MacAnalog/agentic-design-pam4-driver-ihp130/README.md

# Agentic design of a 96 Gb/s PAM-4 driver — IHP SG13G2 (130 nm SiGe BiCMOS)

AI-agent-driven, fully scripted design of an inductorless PAM-4 optical
modulator driver — a block-level replication of *Inac et al., "Inductorless
96 Gb/s PAM-4 Optical Modulators Driver in SiGe:C BiCMOS," EuMIC 2022* on
the open IHP SG13G2 PDK — taken from netlist to DRC/LVS-clean parameterized
layout, kpex extraction, and a layout + electrical co-optimization that
closes **all eight post-layout specs** — first with a block-local optimizer
(v2), then by running the paper's **layout/schematic co-design algorithm
through the SpiceXplorer platform** (`spicexplorer-optimize`,
`sim_engine: layout`; three rounds — **v4** is the layout of record). The audit
trail is four notebooks plus a self-contained **reviewer report** ([`report/`](report/README.md):
schematic vs v1 / v2 / v3 / v4 layouts through the same benches, DRC/LVS/PEX
evidence, GDS + netlists, KLayout renders, eyes, tables — `make report`);
every result below reproduces from this repo — and every number in the
final table can be re-run by hand from static ngspice decks:
[`verification/`](verification/README.md) (`make verify-report`).

## The layout journey

Original v1 layout (edge-fed input, 1.8 µm output-bus gap, nx=2 / R_C=70 Ω
electrical point) → the co-designed layout of record (v4):

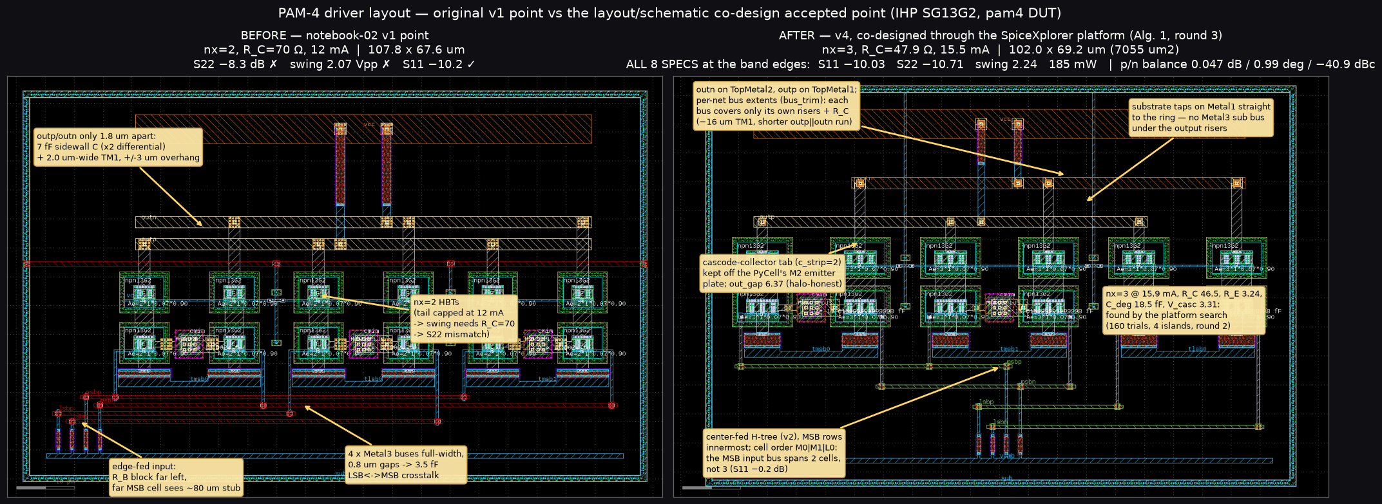
[picture p1: layout/before_after.png]
before/after layout: original v1 vs the co-designed layout of record


The first optimization pass scored only S11/BW/gain/power — and its winner
(nx=2, R_C=70 Ω) sailed through those while silently **failing S22
(−8.3 dB) and output swing (2.07 Vpp)**, caught by the full signoff
(notebook 03). An expert RF layout review + a directed probe ladder
produced the v2 fix (`layout/before_after_v2.png` shows v1 → v2), and the
punchline: **once the layout was repaired, the electrical optimum returned to
the paper's nominal topology** (nx=3, R_C=50 Ω) — the odd v1 sizing had been
compensating layout parasitics.

| step | what was learned / changed | effect |
|---|---|---|
| v1 signoff | S22 and swing were never in the objective — R_C=70 bought gain with output mismatch | S22 −8.3 ✗, swing 2.07 ✗ |
| C-budget from extraction | output C, not R_C mismatch, limits S22: ~14 fF/side of bus wiring (kpex charges TM1 37 aF/µm of *edge* to substrate — length is everything) + ~14 fF/side cascode junctions; outp↔outn sidewall counts **double** differentially | fix must be geometric |
| output-network fixes | bus gap 1.8→8 µm, min-width TM1, slim risers/via stacks, ±1.5 µm overhang, compacted row | S22 −8.4 → **−10.14** at R_C=50 |
| input-network fixes | center-fed H-tree R_B (kills the far-MSB-cell ~80 µm stub), Metal4 buses with MSB rows innermost, 3 µm pair gap, Metal2 base drops | msb S11 at nx=3: −8.8 → −9.9 |
| electrical re-tune | tail 15 mA, R_B 48, V_casc 3.35, and **R_E 2.5→3.2 Ω** — series feedback shrinks the effective input C (the HBT model scales with Nx only) | S11 **−10.03** ✓ with gain 8.25 ✓ |
| verify | kpex RC mode ≡ CC mode to 0.01 dB; DRC + LVS clean on all 3 DUTs | point frozen as v2 (`gen_layout.V2_LAYOUT`) |

### v3 — co-design through the platform (2026-08-18)

Running the same loop *through* `spicexplorer-optimize` (Algorithm 1 of the
TCAS paper: agent owns the generator + bounds, platform owns the search,
DRC/LVS as gates; `layout/codesign/`) first fixed the **instrument** — the
v2 "−10.03 / −10.14" were the worst points of a `dec 20` grid that never
samples 32 / 50 GHz; at the band edges v2 reads **−9.94 / −9.24 dB and
fails both reflection specs** — and the extractor's 8 µm sidewall halo
(`out_gap` sat on it; now `pex.halo_um: 20`). Round 1 (120 trials) skipped
47 % of its budget on generator DRC bugs → three guards; round 2 turned the
layout review into five **structural INT knobs** (`bus_trim`, `sub_bus`,
`cell_order`, `c_strip`, `out_split`) and found the accepted point:

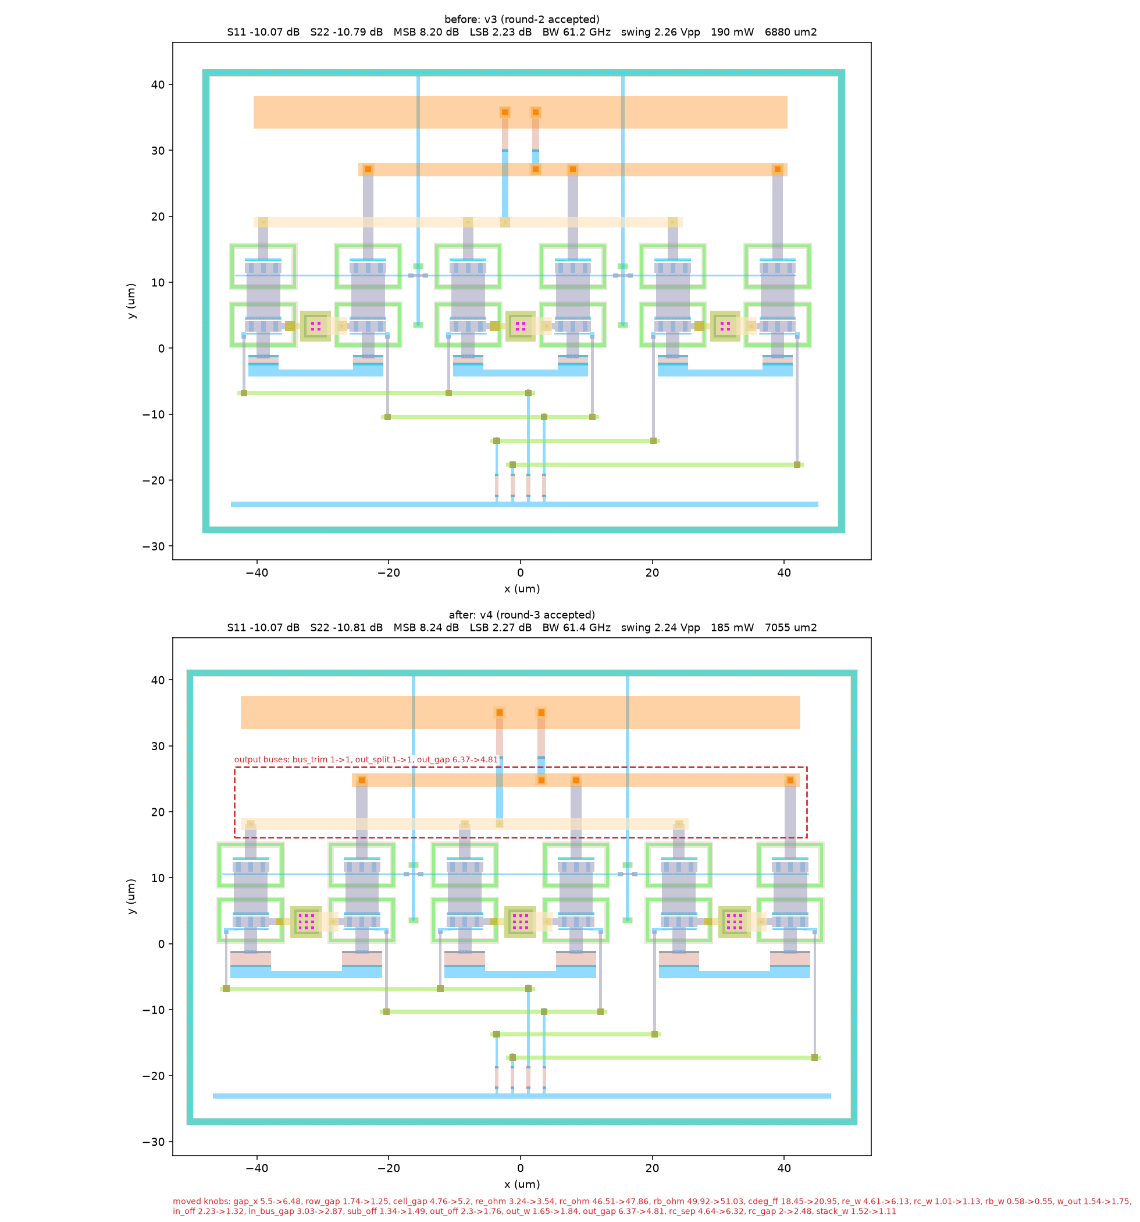
[picture p2: layout/codesign/before_after.png]
before/after co-design


| | v2 (record) | **v3 accepted** |
|---|---|---|
| S11 @32 GHz / S22 @50 GHz | −9.94 / −9.24 dB ✗✗ | **−10.05 / −10.72 dB** ✅✅ (halo 20: −10.07 / −10.78) |
| gain LSB / MSB, BW, swing, power | 2.27 / 8.25 dB, 58.8 GHz, 2.21 Vpp, 179 mW | 2.23 / 8.21 dB, 61.1 GHz, 2.26 Vpp, 190 mW |
| core area | 7552 µm² | **6880 µm²** (−9 %; −39 % vs the paper's 11 300) |

### v4 — co-design round 3: p/n balance as an objective (2026-08-18)

The r2 review's open item was **matching**: the accepted v3 floorplan is
asymmetric by construction (one output bus on TopMetal2, per-net bus trimming)
and its p/n balance had degraded (0.053 dB / 1.18° / −39.4 dBc against v2's
0.03 / 0.5° / −46.5). Round 3 measured the balance of *both* DAC paths in the
hook, made it a **reward** in `J` (with power), and added the knobs the
extraction pointed at — the symmetric/mirrored `out_split` variants, a
p/n-swapped input row order, and `rc_gap` (the outn bus ↔ TopMetal2 vcc rail,
2.34 fF against outp's 0.26). 520 trials over 14 islands:

| | v3 | **v4 accepted** |
|---|---|---|
| S11 @32 GHz / S22 @50 GHz (halo 20 CC) | −10.070 / −10.790 dB | **−10.073 / −10.812 dB** |
| p/n \|gain\| / phase / diff→CM ≤ 48 GHz | 0.043 dB / 0.88° / −41.9 dBc | **0.035 dB / 0.64° / −44.5 dBc** |
| gain LSB / MSB, BW, swing, power | 2.232 / 8.205 dB, 61.2 GHz, 2.26 Vpp, 190.2 mW | 2.269 / 8.244 dB, 61.4 GHz, 2.24 Vpp, **185.0 mW** |
| core area | 6880 µm² | 7055 µm² (+2.5 %; −38 % vs the paper's 11 300) |

The *symmetric* metal options and the input-row swap were measured and are
**nulls** — the balance came from the per-net C budget (output-net asymmetry
2.01 → 1.46 fF) and the electrical point; and the round's ceiling is that
every larger balance gain costs 0.1–0.5 dB of S22 (only 6 of 520 trials hold
both reflections at the v3 level).

Full story, rounds table, ceiling analysis and the annotated parameterized
layout: [layout/codesign/README.md](layout/codesign/README.md); notebook 04.

#### Where the co-optimization actually happens (the script to read)

The agent-generated layout (`layout/gen_layout.py`, a gdsfactory generator
whose `LayoutParams` are the knobs) and the schematic sizing were co-optimized
**by `spicexplorer-optimize`**, not by any loop in this repo. Everything the
platform needs is in **[`layout/codesign/`](layout/codesign/)** — three files:

| file | role in Alg. 1 |
|---|---|
| [`flow.yaml`](layout/codesign/flow.yaml) | `layout-flow/1`: *what one trial is* — `generator: ../gen_layout.py`, `cell`, KLayout DRC + LVS (per-trial reference from the generator), kpex 2.5D (`mode: CC`, MIM stripped, `halo_um: 20`), and the `measure:` hook; `gates: {drc, lvs, pex}` = the skip rule |
| [`project_setup.yaml`](layout/codesign/project_setup.yaml) | `sim_engine: layout`: *the search* — `dut_params` = θ_E ∪ θ_L ∪ θ_S with `init` = the layout of record (`seed_from_init`), `target_specs` = the eight signoff specs as feasibility bounds + S11/S22/p-n-balance/power/area margins as the reward (`feasibility_reward` J), `ic_ma_per_finger` validity, DRC/LVS/PEX gates as `exact 1` specs |
| [`measure_post.py`](layout/codesign/measure_post.py) | the hook `measure(req) -> scalars`: kpex netlist → `pex_sim.convert_pex_netlist` (MIM re-inserted) → `wrap_layout_dut` → the block's own `driver_lib` benches (`run_ac`, `run_ac_s22`, `run_dc`, bias) with the trial's sizing + `deck_params` (tail, V_casc) → `s11, s22, msb_gain, lsb_gain, weight, bw, swing, power, ic_ma_per_finger` |

```yaml
# project_setup.yaml (excerpt) — one line per knob; the platform owns Opt.ask/tell
project:
  sim_engine: layout
  netlist: flow.yaml                     # the DUT "netlist" is the layout-flow spec
  dut_params:
    - { name: nx,       min_val: 2,   max_val: 4,    init: 3,    is_integer: true }   # θ_E (draws geometry)
    - { name: tail_ma,  min_val: 10.0, max_val: 17.5, init: 15.0 }                    # θ_E (bench-only -> deck_params)
    - { name: rc_ohm,   min_val: 40.0, max_val: 70.0, init: 50.0 }
    - { name: out_gap,  min_val: 3.0,  max_val: 20.0, init: 8.0 }                     # θ_L (um)
    - { name: bus_trim, min_val: 0,   max_val: 1,    init: 0,    is_integer: true }   # θ_S (round-2 structural option)
    # ... 33 knobs in all
  target_specs:
    - { name: s11, goal: minimize, target: -10.0, range: 5.0, weight: 10, reward_type: relative-absolute }
    - { name: s22, goal: minimize, target: -10.0, range: 5.0, weight: 10, reward_type: relative-absolute }
    - { name: msb_gain, goal: exceed, target: 8.2, range: 1.0, weight: 5, reward_type: none }
    # ... lsb_gain, weight, bw, swing, power, ic_ma_per_finger, drc_pass/lvs_match/pex_ok (exact 1)
  optimizer_config: { type: nevergrad, name: TwoPointsDE, seed_from_init: true }
```

One island of a round is one platform command (what `run_round.sh` /
`make codesign` wrap):

```sh
uv run --project ../../../../spicexplorer-platform spicexplorer-optimize \
    layout/codesign/project_setup.yaml --budget 40 --seed 0 --algo OnePlusOne \
    --outdir layout/codesign/runs/r2_s0
```

Every trial leaves `runs/<round>_s<seed>/layout/layout/run_<n>_layout/{pam4drv_pam4_lay.gds, drc/, lvs/, pex/, measure.log, summary.json}`;
`harvest.py` folds the islands into `results/<round>/{trials.jsonl,summary.json,best.*}` — the record R the agent reads
(and notebook 04 plots). The agent's part of the loop is only the diff of `gen_layout.py` and the bounds between rounds
(`rounds/r1_project_setup.yaml` → `project_setup.yaml`).

Open pre-tapeout items from the review (vcasc bypass/stability, EM current
density, ground cage, matching dummies) are tracked in
[layout/LAYOUT_REVIEW.md](layout/LAYOUT_REVIEW.md).

## Results

| metric (post-layout `pam4`, kpex 2.5D) | paper (meas.) | EIC ref (schem) | v2 (2026-08-09) | v3 (co-design r2) | **v4 (layout of record)** | spec |
|---|---|---|---|---|---|---|
| LSB / MSB LF gain | 3.2 / 9.2 dB | 3.10 / 9.07 | 2.27 / 8.25 dB | 2.23 / 8.20 dB | **2.27 / 8.24 dB** | ≥ 2.2 / ≥ 8.2 ✅ |
| DAC weight | 6.0 dB | 5.97 | 5.98 dB | 5.97 dB | **5.97 dB** | ≥ 5.0 ✅ |
| Bandwidth (worst path) | 51–67 GHz | 66.6 | 58.8 GHz | 61.1 GHz | **61.1 GHz** | ≥ 50 ✅ |
| S11 at 32 GHz | < −10 | −10.87 | −9.94 dB ✗ | −10.05 dB | **−10.03 dB** | ≤ −10 ✅ |
| S22 at 50 GHz | < −10 | −14.75 | −9.24 dB ✗ | −10.72 dB | **−10.71 dB** | ≤ −10 ✅ |
| p/n balance ≤ 48 GHz (gain / phase / diff→CM) | — | ideal | 0.03 dB / 0.5° / −46.5 dBc | 0.05 dB / 1.2° / −39.5 dBc | **0.05 dB / 1.0° / −40.9 dBc** | audit |
| Max diff swing | 2.1 Vpp | 2.37 | 2.21 Vpp | 2.26 Vpp | **2.24 Vpp** | ≥ 2.1 ✅ |
| Power | 192 mW | 191 | 179 mW @ 4 V | 190 mW @ 4 V | **185 mW @ 4 V** | ≤ 192 ✅ |
| 48 GBd PAM-4 eye (200 mV$_{pp}$ in) | Fig. 5 | RLM 0.995, 0.25 V eyes | RLM 0.995, 0.23 V eyes | RLM 0.995, 0.23 V eyes | **RLM 0.994, 0.23 V eyes** | open ✅ |
| Core area | 0.011 mm² | — | 0.0076 mm² | 0.0069 mm² | **0.0071 mm²** (102.0 × 69.2 µm) | — |

S11/S22 are the worst in-band values *including the interpolated 32 / 50 GHz
band edge* (kpex CC, tech halo 8 µm — the block's default instrument; the
v2 column is the record re-measured that way, see the v3 section above). The
co-design search runs at halo 20, where v4 reads −10.073 / −10.812 dB and
0.035 dB / 0.64° / −44.5 dBc — better than v3 on every one of them.
Eye metrics are read at the eye centre (`report/build_report.py`; the
notebooks sample at a fixed phase and read RLM ≈ 0.97). All five tiers —
schematic, first-pass layout, v2, v3, v4 — side by side with the same instrument,
plus the p/n balance audit and per-tier DRC/LVS/PEX evidence, are in
[`report/`](report/README.md) (`report/data/tables.md`).
Both columns through the same `driver_lib` benches (notebook 04 §5):

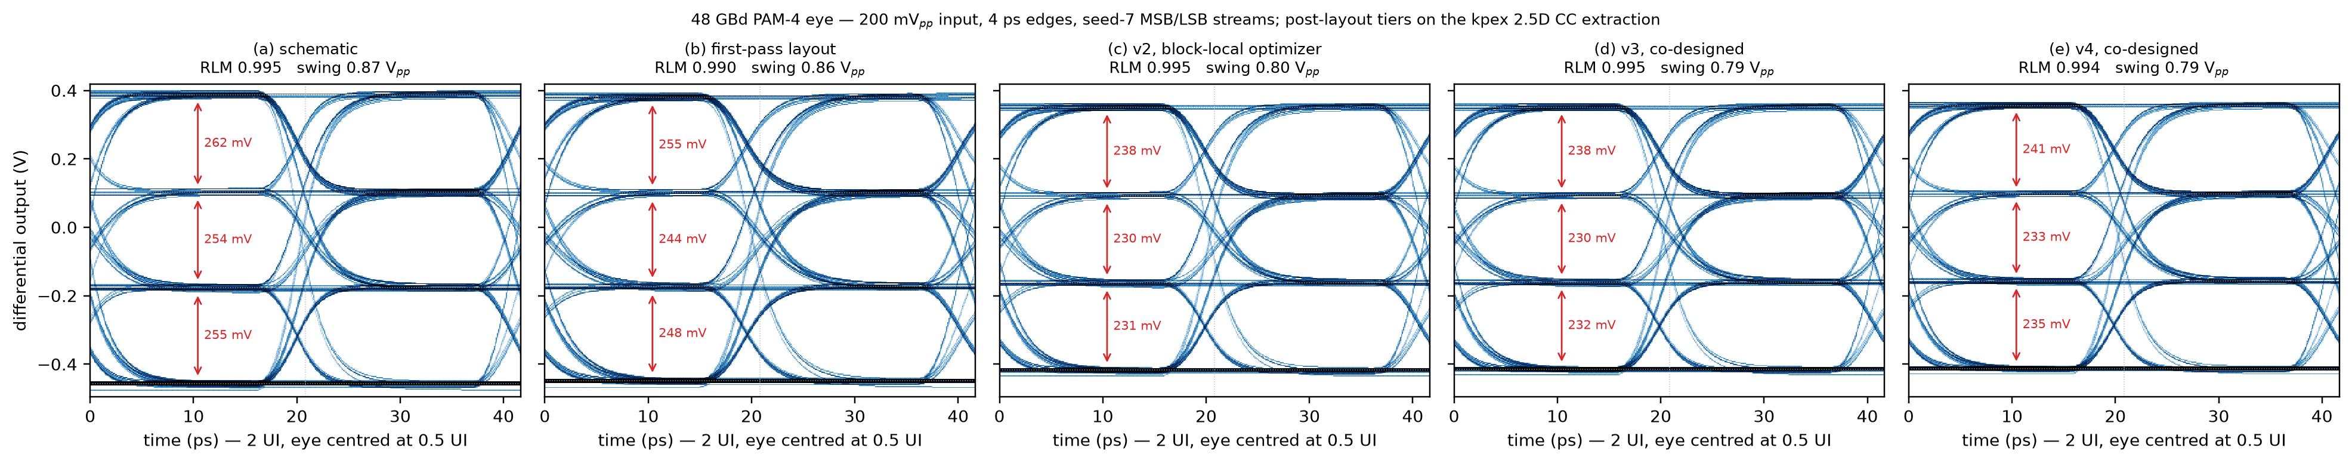
[picture p3: report/figs/fig_eye.png]
48 GBd eyes, all five tiers


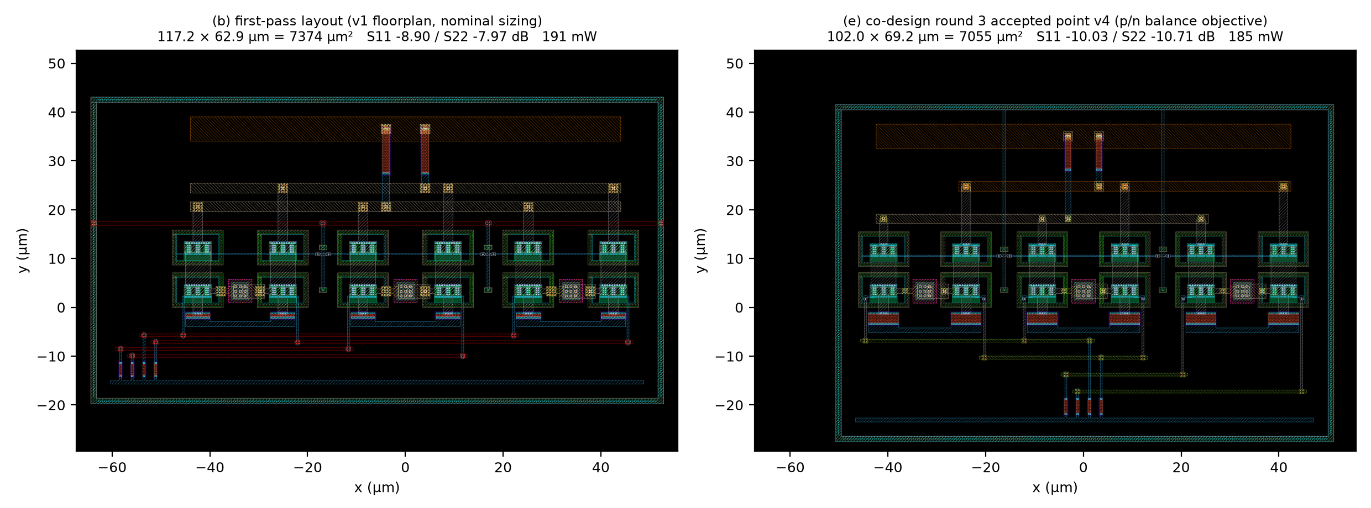
[picture p4: report/figs/fig_layout_b_vs_d.png]
first-pass vs co-designed layout, KLayout render


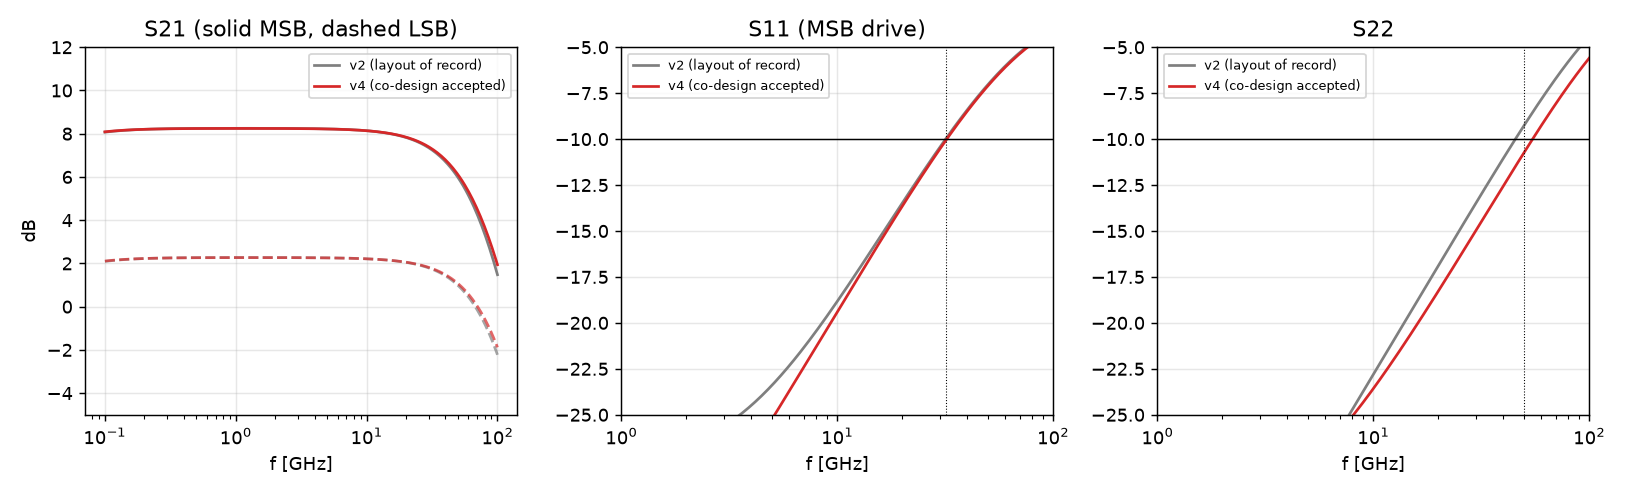
[picture p5: notebooks/report_figs/sparams_v2_v4_post_layout.png]
v2 vs v4 S-parameters


**S-parameters, all five tiers** (S21 both paths, S11, S22 — schematic /
first-pass / v2 / v3 / v4, `report/`):

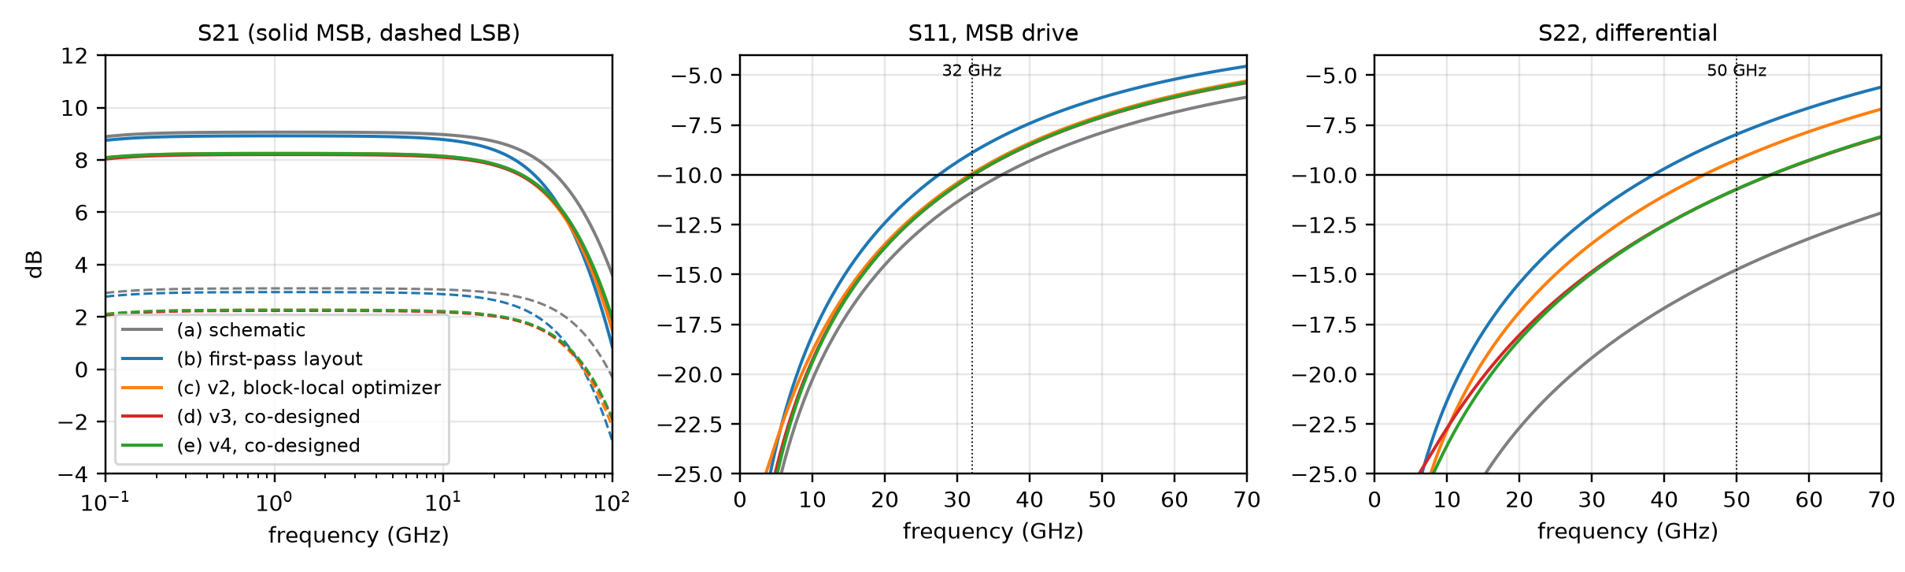
[picture p6: report/figs/fig_sparams.png]
s-parameters


**DC transfer** (swing signoff, all tiers) and **p/n balance audit**:

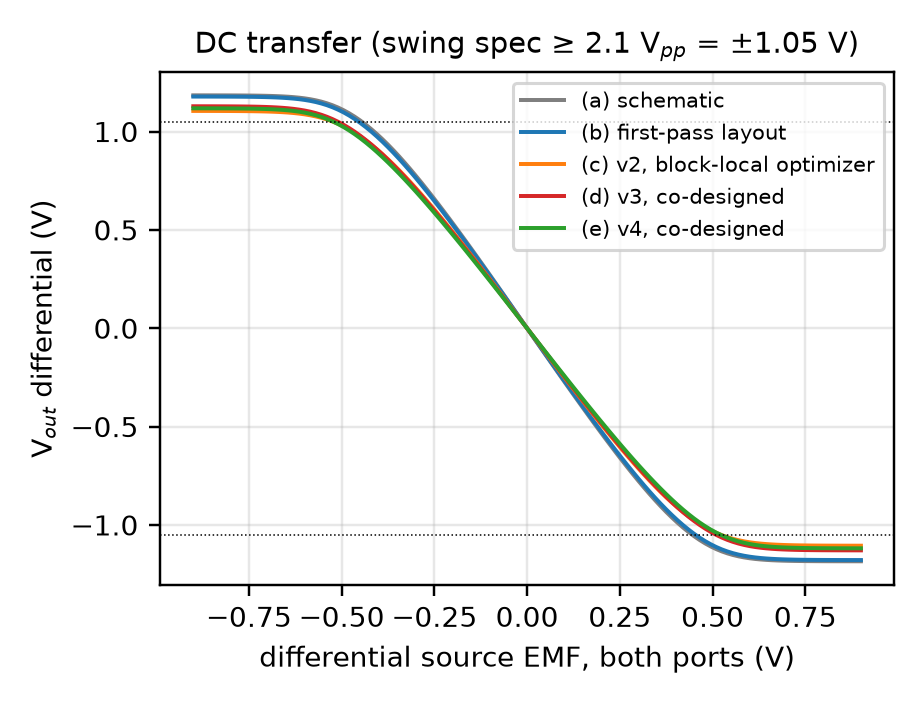
[picture p7: report/figs/fig_dc.png]
dc transfer

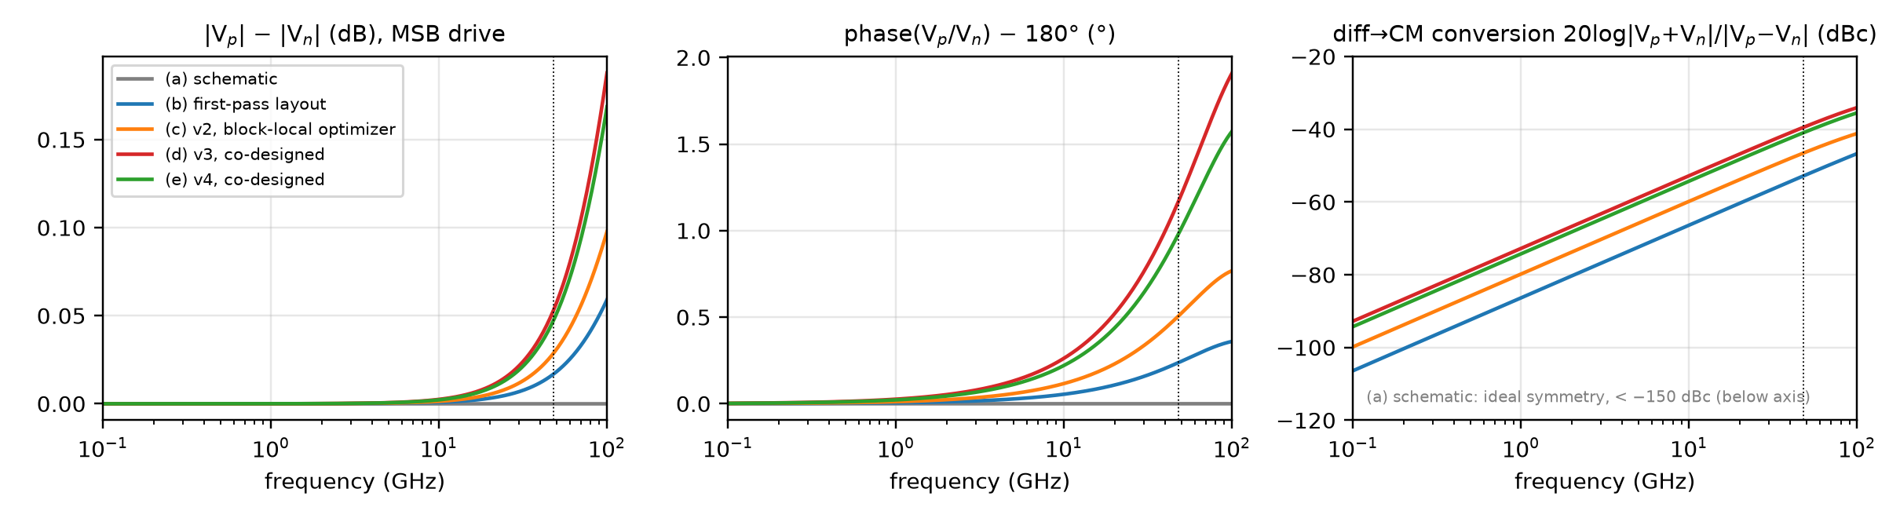
[picture p8: report/figs/fig_balance.png]
balance


**Final pam4 layout — v4, the layout of record** (3 differential cascode
cells summing into shared collector loads; DRC + LVS clean; KLayout render,
every optimizer knob annotated):

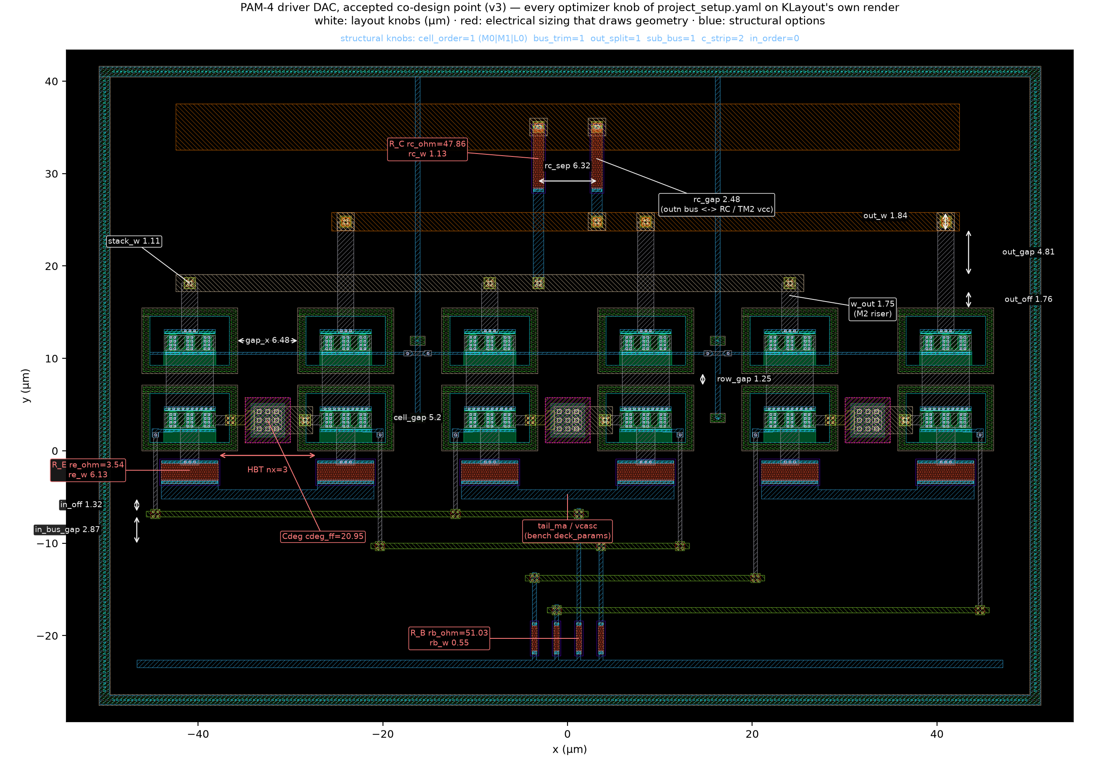
[picture p9: report/figs/fig_layout_annotated.png]
final layout v4


The notebook-03 signoff figures (`notebooks/report_figs/{pam4_layout_final,
eye_48gbd_pam4,sparams_s21_s11_s22,dc_transfer_dac_levels}.png`) are the
**v2** layout of record (they run on `layout/out/pex/dut_pam4_best_post.spice`);
`report/` supersedes them for v3 / v4.

The report plots regenerate with `make report`, the notebook plots from
`notebooks/03_signoff.py`; the executed
notebooks (`.ipynb` built locally from the paired `.py`, `make notebooks`)
contain every table and figure inline:

| notebook | contents |
|---|---|
| [01_schematic_sizing](notebooks/01_schematic_sizing.py) | DUT schematics, testbenches, nominal sizing, bias/S-param/eye vs the verified reference |
| [02_layout_in_the_loop](notebooks/02_layout_in_the_loop.py) | gdsfactory generation, DRC/LVS, kpex, co-optimization with the **full 8-spec objective** |
| [03_signoff](notebooks/03_signoff.py) | DC/tran/AC/eye on schematic **and** post-layout through the *same* benches; master spec table; `emitter_width=0.07` validity proof |
| [04_codesign_platform](notebooks/04_codesign_platform.py) | the platform co-design record (`layout/codesign/results/`): per-round trial scatter / skip rates, round-by-round scorecard vs the honest baseline, moved knobs, annotated parameterized layout + before/after + rounds strip |

## Repo map

```
dut/          three DUT subcircuits (lsb / msb / pam4 2-bit DAC)
netlists/     static, directly runnable ngspice decks (+ .spiceinit)
testbenches/  driver_lib.py — netlist-agnostic benches (schematic AND
              post-layout via dut_ref=), run_verify.py, run_eye.py
layout/       gen_layout.py (parameterized generator, FINAL_LAYOUT = v4,
              V3_LAYOUT, V2_LAYOUT), signoff.py (DRC+LVS, vendored PDK runner),
              pex_sim.py (kpex), optimize_layout.py (block-local v1/v2 loop),
              LAYOUT_REVIEW.md, before_after.png (v1 -> v4; _v2/_v3 = v1 -> v2/v3),
              codesign/ (Alg. 1 through spicexplorer-optimize: flow.yaml,
              project_setup.yaml, measure hook, rounds/, results/, figures),
              out/ (v3 netlists, PEX, renders; GDS regenerates)
report/       reviewer report — build_report.py, README.md, figs/, data/
              (tables + raw sweeps), layout/<tier>/ (GDS + LVS/kpex/post
              netlists + DRC/LVS logs), schematic/  (make report)
verification/ static ngspice decks per tier + extract.py + verify.py:
              re-run and check every final number (make verify-report)
notebooks/    jupytext .py sources (+ locally built .ipynb) + report_figs/
results/      committed characterization plots + metrics YAML
schematics/   xschem schematics (paper Fig. 1 / 2a / 2b)
docs/         REFERENCE.md — detailed methods, measurement conventions,
              JPP-361 ngspice finding, provenance
```

## EDA tool setup

One-time, per machine. Install the tools wherever you like, then record the
paths in an untracked `local.mk` at the repo root — the Makefile injects
them into every flow.

1. **PDK** — clone [IHP-Open-PDK](https://github.com/IHP-GmbH/IHP-Open-PDK);
   `PDK_ROOT` = the directory containing `ihp-sg13g2`.
2. **ngspice 45** on `PATH` — build from
   [ngspice](https://ngspice.sourceforge.io) or use a distro package.
   Version 45+ is required for the full suite: on 44 the self-heating VBIC
   HBT fails `.op/.ac/.dc` (transient benches only — docs/REFERENCE.md).
3. **Python 3.11+** via [uv](https://docs.astral.sh/uv/): `uv sync` creates
   `.venv` from `uv.lock` (includes the `klayout` Python module the DRC/LVS
   runners use — no KLayout app install needed for signoff).
4. **klayout-pex ≥ 0.3.12** (*optional* — parasitic re-extraction only, see
   below): `pip install klayout-pex` in any env, or
   [releases](https://github.com/martinjankoehler/klayout-pex). Its LVS step
   additionally drives a **KLayout ≥ 0.30 executable** built with
   Ruby ≥ 2.6 ([klayout.de](https://www.klayout.de/build.html)). Both are
   found on `PATH` (`kpex`, `klayout`); override with `KPEX` /
   `KPEX_KLAYOUT_EXE` if they live elsewhere.

```make
# local.mk (untracked) — example
PDK_ROOT         = /opt/pdks
KPEX             = /opt/kpex/bin/kpex
KPEX_KLAYOUT_EXE = /opt/klayout/klayout
```

Ad-hoc runs outside `make` work the same way with environment variables:
`export PDK_ROOT=... PDK=ihp-sg13g2 [KPEX=... KPEX_KLAYOUT_EXE=...]`.

## Running it

```sh
make sync        # uv sync — create/update the Python env
make verify eye  # schematic benches + PAM-4 eye (results/*)
make signoff     # layout DRC + LVS on all three DUTs
make nb03        # execute the signoff notebook (jupytext -> .ipynb)
make report      # rebuild report/ (all tiers, DRC/LVS/PEX, benches, eyes)
make verify-report  # re-run every final number from static decks + DRC/LVS, PASS/FAIL vs record
```

`make all` runs everything (incl. notebooks 01/02; 02 is the
layout-in-the-loop optimizer — takes a while, tune with `NB_BUDGET=n`).
Any variable can also be set per-invocation, e.g.
`make signoff PDK_ROOT=/opt/pdks`. The `.ipynb` notebooks are generated
from the paired `.py` files and are not tracked.
A raw one-off deck: `cd netlists && ngspice -b tb_pam4_sparam_msb_1ghz.spice`.

Post-layout results reproduce **without kpex**: the converted PEX netlists
are committed (`layout/out/pex/dut_*_post.spice`) and every bench runs on
them via `run_ac(..., dut_ref=pex_sim.wrap_layout_dut("pam4", <netlist>))`.
The `.spiceinit` (`set ngbehavior=hsa`) is mandatory — without it the HBT
conducts 0 A silently; the Python runners write it automatically.

## Provenance

Port of the EIC-designer `lumped-broadband-driver` verified reference,
reproduced with zero delta on all 8 system metrics
(`results/pam4_results.yaml`). Designed, laid out, verified, and
re-optimized end-to-end by AI agents (Claude), including an independent
multi-agent RF layout review; the notebooks and `report/` are the
human-facing audit trail.
