MacAnalog/agentic-design-pam4-driver-ihp130/notebooks/README.md

# Case-study notebooks

Authored as **jupytext percent-format `.py` sources** (the `.py` files are
the single source of truth; the `.ipynb` are generated/executed locally and
are git-ignored — build them with `make nb01 nb02 nb03 nb04`).

| Source | Notebook | Content |
|---|---|---|
| `01_schematic_sizing.py` | `01_schematic_sizing.ipynb` | 3 DUT schematics, testbenches, nominal sizing, bias + S-parameter + eye characterization vs the EIC golden reference |
| `02_layout_in_the_loop.py` | `02_layout_in_the_loop.ipynb` | gdsfactory layout generation, DRC/LVS signoff, kpex PEX, and layout + electrical co-optimization (nx, tail, R_C, R_B, C_deg, V_casc) with the full toolchain in the loop; closes back to the schematic level |
| `03_signoff.py` | `03_signoff.ipynb` | full signoff — DC transfer/DAC levels/swing, transient bias ramp + tran-vs-ac method cross-check, S21/S11/S22 sweeps, 48 GBd eye — running the *same* `driver_lib` benches on the schematic DUTs and the kpex post-layout netlist (`pex_sim.wrap_layout_dut` + `dut_ref=`); master table vs paper specs / paper measurements / EIC golden; documents the EIC-had-no-layout evidence and the two residual gaps (post-layout S22, swing). **Post-layout = the v2 layout of record** (`layout/out/pex/dut_pam4_best_post.spice`); the v3 / v4 signoff is in `../report/` (tiers d/e) and notebook 04 §5 |
| `04_codesign_platform.py` | `04_codesign_platform.ipynb` | the layout/schematic co-design record produced *through the SpiceXplorer platform* (`layout/codesign/results/`): trials per round (status, feasibility, skip rate), scorecard per round vs the honest baseline (`results/baseline_r2_instrument.json`) and the paper, moved knobs vs the layout of record, and the annotated / before-after / rounds figures. Read-only — nothing re-runs the optimizer (`layout/codesign/README.md` says how) |

Build / re-execute (uv env; `PDK_ROOT` set per the top-level README —
or just `make nb01 nb02 nb03 nb04` from the repo root):

```sh
uv run jupytext --sync 01_schematic_sizing.py     # .py <-> .ipynb pairing
uv run jupytext --to notebook --execute 01_schematic_sizing.py
NB_BUDGET=14 uv run jupytext --to notebook --execute 02_layout_in_the_loop.py
```

Notebook 02 runs the real signoff/PEX/simulate chain per optimizer trial
(~30–90 s each; `NB_BUDGET` sets the trial count). Trial workspaces land in
`nb_opt/` (only the best trial is kept).

Notebook 04 build (reads only the committed JSON record + PNGs — no PDK or
platform env needed):

```sh
uv run jupytext --to notebook --execute 04_codesign_platform.py    # or: make nb04
```

Notebook 03 build:

```sh
uv run jupytext --to notebook --execute 03_signoff.py
```

It reuses the best-trial PEX netlist (`layout/out/pex/dut_pam4_best_post.spice`,
copied from `nb_opt/pam4_best/`); regenerate it via notebook 02 or
`layout/pex_sim.py` if absent.

For a reviewer-facing, self-contained summary of every simulation (schematic
vs v1 / v2 / v3 layouts: S-parameters, balance, DC, eyes, DRC/LVS/PEX
evidence, GDS + netlists) see [`../report/`](../report/README.md)
(`make report` rebuilds it).
