MacAnalog/agentic-design-pam4-driver-ihp130/report/figs/fig_balance.pdf

|Vp| − |Vn| (dB), MSB drive

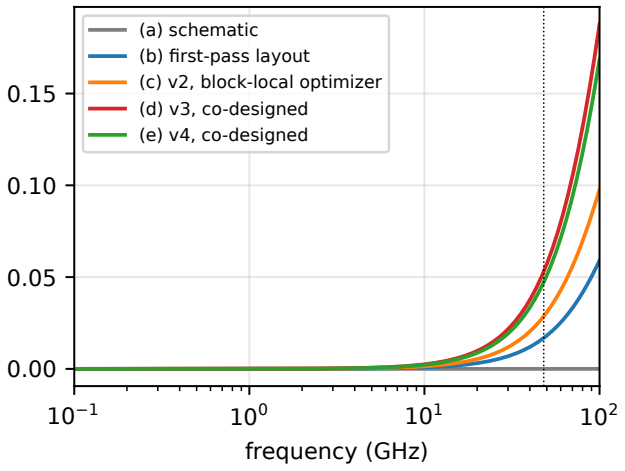
[picture p11: figure]
frequency (GHz); (d) v3, co-designed (e) v4, co-designed

(a) schematic (b) first-pass layout (c) v2, block-local optimizer

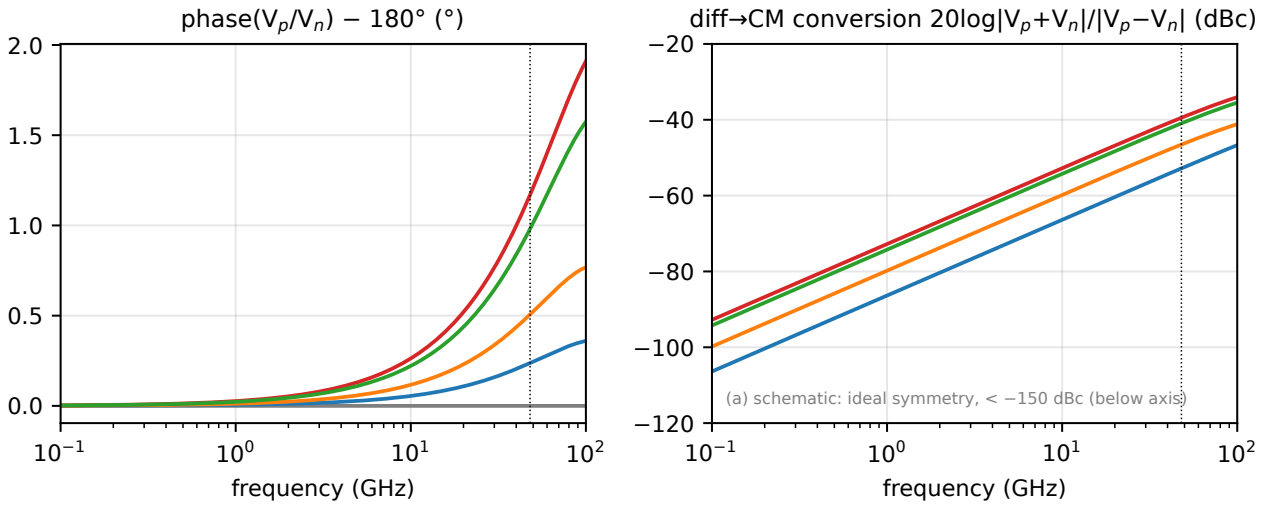
[picture p12: figure]
frequency (GHz); phase(Vp/Vn) − 180° (°); diff→CM conversion 20log|Vp+Vn|/|Vp−Vn| (dBc)

0 | 10
1 | 10
2
frequency (GHz)
(a) schematic: ideal symmetry, < −150 dBc (below axis)
