MacAnalog/agentic-design-pam4-driver-ihp130/layout/codesign/before_after.pdf

−40 | −20 | 0 | 20 | 40
| | x (um)

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
## y (um)

## before: v3 (round-2 accepted)

S11 -10.07 dB S22 -10.79 dB MSB 8.20 dB LSB 2.23 dB BW 61.2 GHz swing 2.26 Vpp 190 mW 6880 um2

−40 | −20 | 0 | 20 | 40
| | x (um)

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
## y (um)

moved knobs: gap_x 5.5->6.48, row_gap 1.74->1.25, cell_gap 4.76->5.2, re_ohm 3.24->3.54, rc_ohm 46.51->47.86, rb_ohm 49.92->51.03, cdeg_ff 18.45->20.95, re_w 4.61->6.13, rc_w 1.01->1.13, rb_w 0.58->0.55, w_out 1.54->1.75, in_off 2.23->1.32, in_bus_gap 3.03->2.87, sub_off 1.34->1.49, out_off 2.3->1.76, out_w 1.65->1.84, out_gap 6.37->4.81, rc_sep 4.64->6.32, rc_gap 2->2.48, stack_w 1.52->1.11

## after: v4 (round-3 accepted)

S11 -10.07 dB S22 -10.81 dB MSB 8.24 dB LSB 2.27 dB BW 61.4 GHz swing 2.24 Vpp 185 mW 7055 um2

output buses: bus_trim 1->1, out_split 1->1, out_gap 6.37->4.81
