MacAnalog/agentic-design-pam4-driver-ihp130/layout/codesign/rounds.pdf

−40 | −20 | 0 | 20 | 40
| | x (um)

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
y (um)

layout of record v2 (r2 instrument)
S11 -9.98 dB S22 -9.36 dB MSB 8.25 dB LSB 2.27 dB BW 59.2 GHz swing 2.21 Vpp 179 mW 7552 um2
−40 | −20 | 0 | 20 | 40
| | x (um)

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
y (um)

r1 best (run_22; r1 instrument, halo 8)
S11 -10.04 dB S22 -10.76 dB MSB 8.21 dB LSB 2.23 dB BW 59.9 GHz swing 2.13 Vpp 173 mW 7664 um2
−40 | −20 | 0 | 20 | 40
| | x (um)

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
y (um)

r2 accepted v3 (s3 run_38) S11 -10.07 dB S22 -10.79 dB MSB 8.20 dB LSB 2.23 dB BW 61.2 GHz swing 2.26 Vpp 190 mW 6880 um2

−40 | −20 | 0 | 20 | 40
| | x (um)

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
y (um)

r3 accepted v4 (s23 run_30) S11 -10.07 dB S22 -10.81 dB MSB 8.24 dB LSB 2.27 dB BW 61.4 GHz swing 2.24 Vpp 185 mW 7055 um2
