MacAnalog/agentic-design-pam4-driver-ihp130/report/figs/fig_eye.pdf

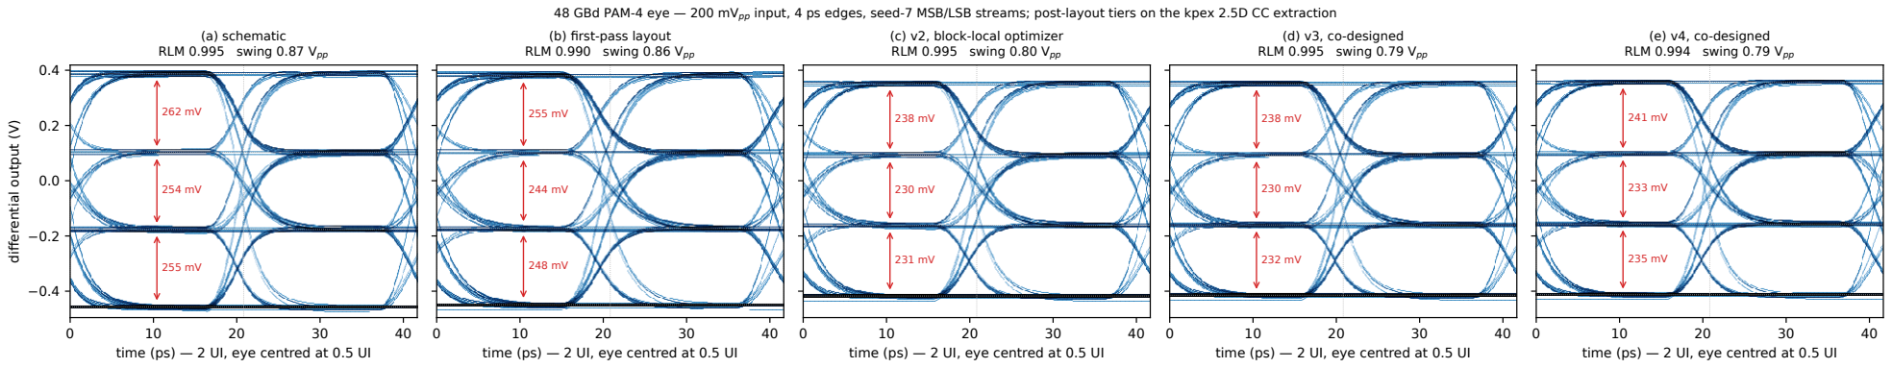
[picture p13: page 1]

0 | 10 | 20 | 30 | 40
time (ps) — 2 UI, eye centred at 0.5 UI

−0.4

−0.2

0.0

0.2

0.4

di

fferential output (V)

255 mV

254 mV

262 mV

(a) schematic
RLM 0.995 swing 0.87 Vpp
0 | 10 | 20 | 30 | 40
time (ps) — 2 UI, eye centred at 0.5 UI

248 mV

244 mV

255 mV

(b) first-pass layout
RLM 0.990 swing 0.86 Vpp
0 | 10 | 20 | 30 | 40
time (ps) — 2 UI, eye centred at 0.5 UI

231 mV

230 mV

238 mV

(c) v2, block-local optimizer RLM 0.995 swing 0.80 Vpp
0 | 10 | 20 | 30 | 40
time (ps) — 2 UI, eye centred at 0.5 UI

232 mV

230 mV

238 mV

(d) v3, co-designed
RLM 0.995 swing 0.79 Vpp
0 | 10 | 20 | 30 | 40
time (ps) — 2 UI, eye centred at 0.5 UI

235 mV

233 mV

241 mV

(e) v4, co-designed
RLM 0.994 swing 0.79 Vpp

48 GBd PAM-4 eye — 200 mVpp input, 4 ps edges, seed-7 MSB/LSB streams; post-layout tiers on the kpex 2.5D CC extraction
