MacAnalog/agentic-design-pam4-driver-ihp130/report/figs/fig_layout_b_vs_d.pdf

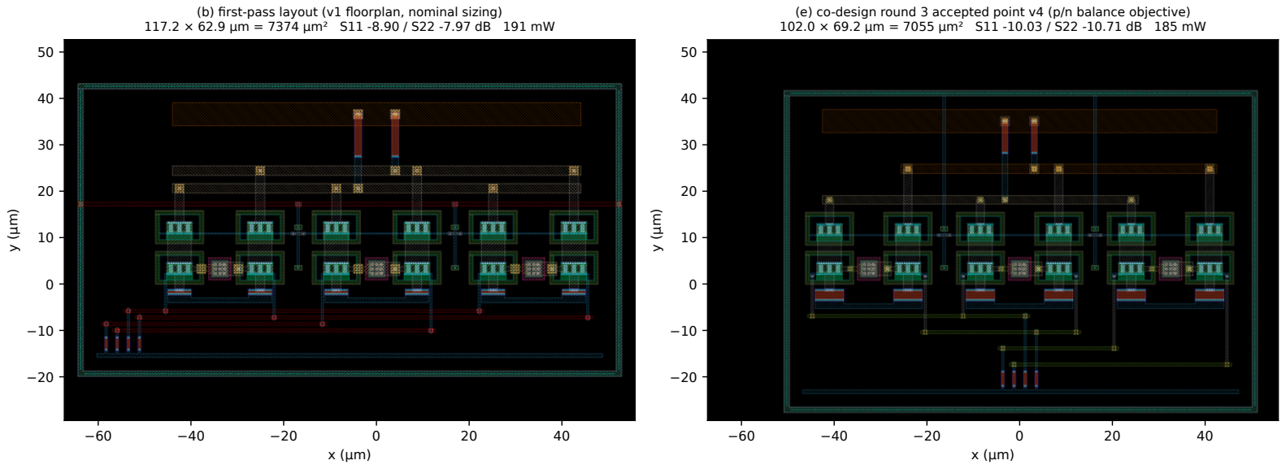
[picture p14: page 1]

−60 | −40 | −20 | 0 | 20 | 40
x (µm)

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
y (µm)

(b) first-pass layout (v1 floorplan, nominal sizing)
117.2 × 62.9 µm = 7374 µm² S11 -8.90 / S22 -7.97 dB 191 mW
−60 | −40 | −20 | 0 | 20 | 40
x (µm)

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
y (µm)

(e) co-design round 3 accepted point v4 (p/n balance objective) 102.0 × 69.2 µm = 7055 µm² S11 -10.03 / S22 -10.71 dB 185 mW
