MacAnalog/agentic-design-pam4-driver-ihp130/report/figs/fig_layouts.pdf

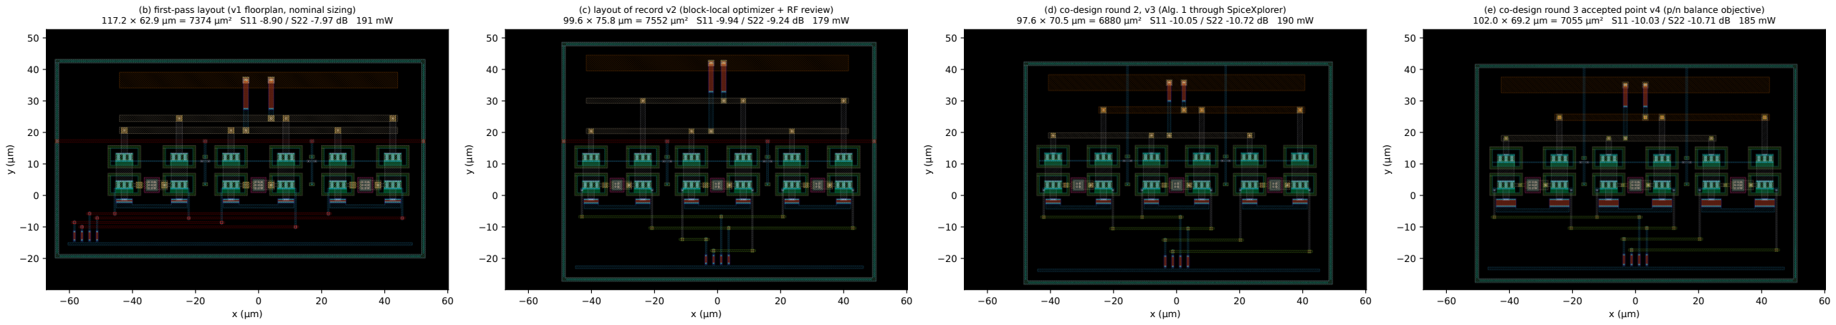
[picture p15: page 1]

−60 | −40 | −20 | 0 | 20 | 40 | 60
| | | x (µm)

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
y (µm)

(b) first-pass layout (v1 floorplan, nominal sizing)
117.2 × 62.9 µm = 7374 µm² S11 -8.90 / S22 -7.97 dB 191 mW
−60 | −40 | −20 | 0 | 20 | 40 | 60
| | | x (µm)

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
y (µm)

(c) layout of record v2 (block-local optimizer + RF review) 99.6 × 75.8 µm = 7552 µm² S11 -9.94 / S22 -9.24 dB 179 mW
−60 | −40 | −20 | 0 | 20 | 40 | 60
| | | x (µm)

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
y (µm)

(d) co-design round 2, v3 (Alg. 1 through SpiceXplorer)
97.6 × 70.5 µm = 6880 µm² S11 -10.05 / S22 -10.72 dB 190 mW
−60 | −40 | −20 | 0 | 20 | 40 | 60
| | | x (µm)

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
y (µm)

(e) co-design round 3 accepted point v4 (p/n balance objective) 102.0 × 69.2 µm = 7055 µm² S11 -10.03 / S22 -10.71 dB 185 mW
