MacAnalog/agentic-design-pam4-driver-ihp130/layout/codesign/before_after_r2.pdf

−40 | −20 | 0 | 20 | 40
| | x (um)

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
## y (um)

## before: layout of record

S11 -9.98 dB S22 -9.36 dB MSB 8.25 dB LSB 2.27 dB BW 59.2 GHz swing 2.21 Vpp 179 mW 7552 um2

−40 | −20 | 0 | 20 | 40
| | x (um)

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
## y (um)

moved knobs: gap_x 6->5.5, row_gap 1.6->1.74, cell_gap 5->4.76, re_ohm 3.2->3.24, rc_ohm 50->46.51, rb_ohm 48->49.92, cdeg_ff 16->18.45, re_w 4.5->4.61, rc_w 1.4->1.01, rb_w 0.5->0.58, w_out 1.5->1.54, in_off 2.2->2.23, in_bus_gap 3->3.03, sub_off 1.4->1.34, out_off 2->2.3, out_w 1.64->1.65, out_gap 8->6.37, rc_sep 4->4.64, stack_w 1.7->1.52

## after: accepted co-design point

S11 -10.07 dB S22 -10.79 dB MSB 8.20 dB LSB 2.23 dB BW 61.2 GHz swing 2.26 Vpp 190 mW 6880 um2

output buses: bus_trim 0->1, out_split 0->1, out_gap 8->6.37

sub_bus 0->1 | sub_bus 0->1
c_strip 0->2 | c_strip 0->2 | c_strip 0->2
M0 | M1 | L0
