MacAnalog/agentic-design-pam4-driver-ihp130/report/schematic/pam4_lsb_vector.pdf

Q3 | Q4
Q1 | Q2
OUT+ | OUT−
VB | VB
IN+ | IN−
R1 | R2

C1

It
