MacAnalog/agentic-design-pam4-driver-ihp130/layout/before_after_v2.png

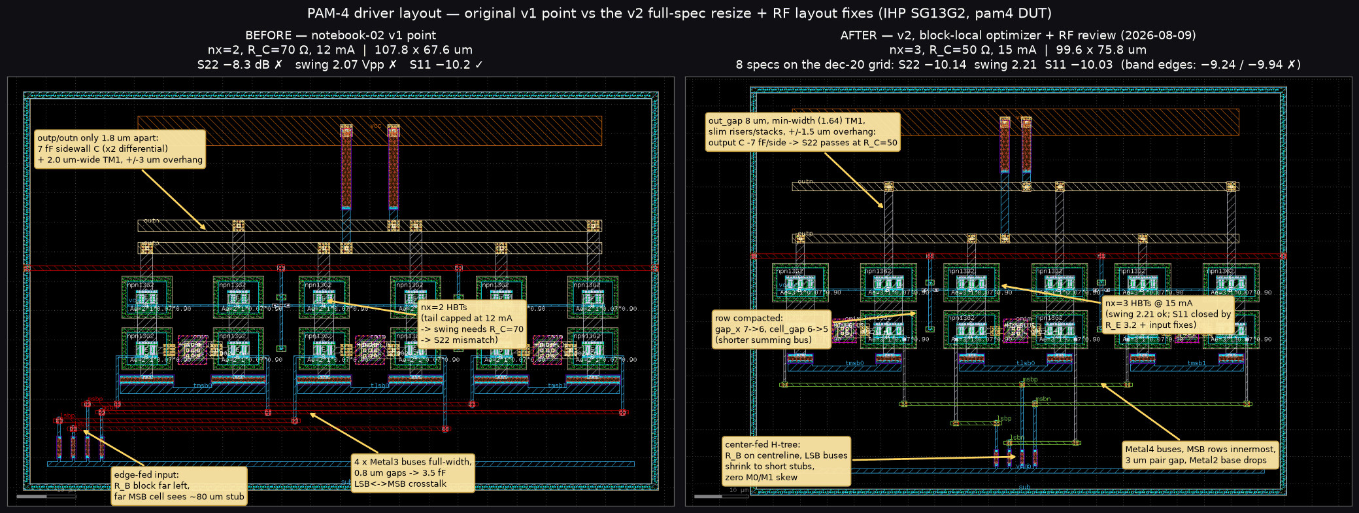
layout/before_after_v2.png
