MacAnalog/agentic-design-pam4-driver-ihp130/layout/codesign/before_after_r2.png

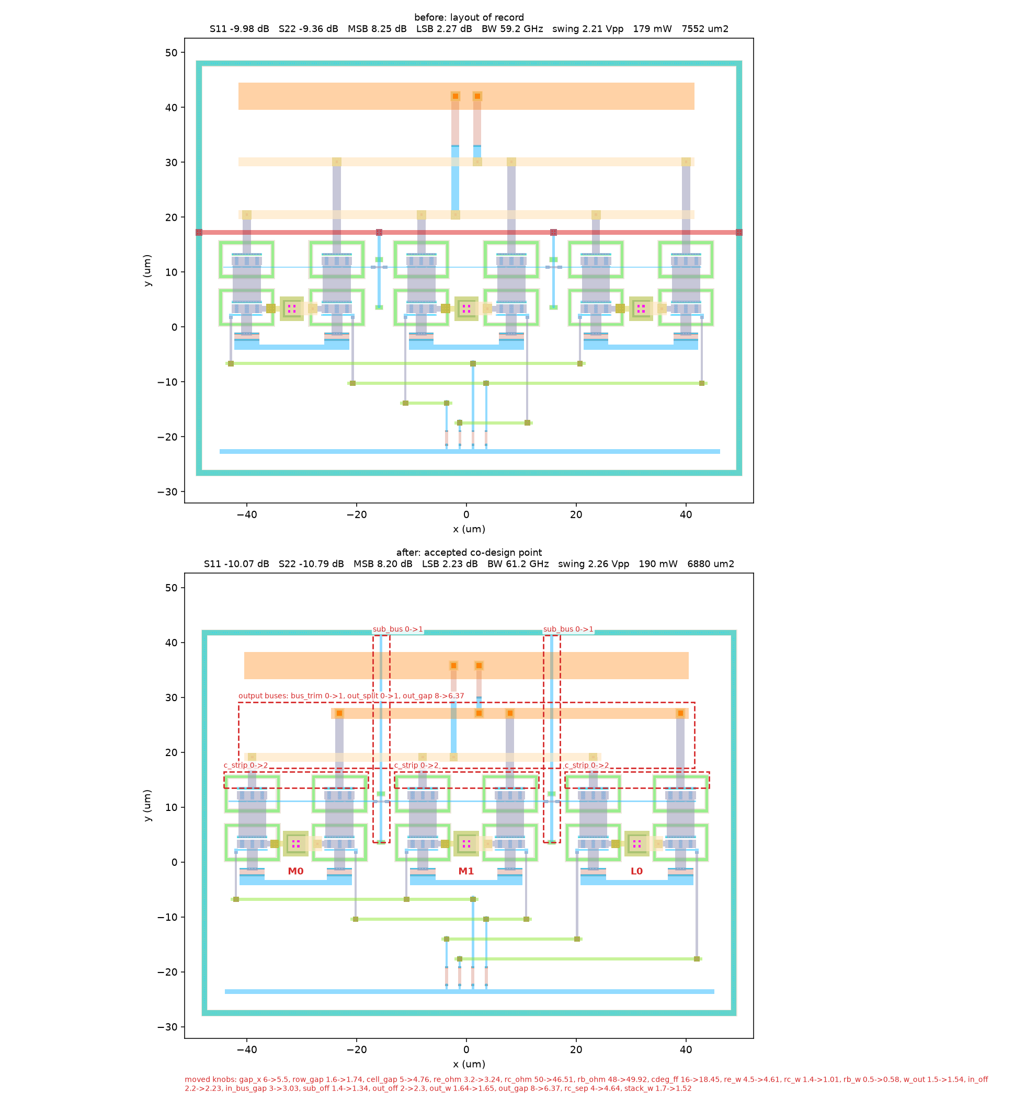
layout/codesign/before_after_r2.png
