MacAnalog/agentic-design-pam4-driver-ihp130/layout/codesign/pam4_layout_annotated.png

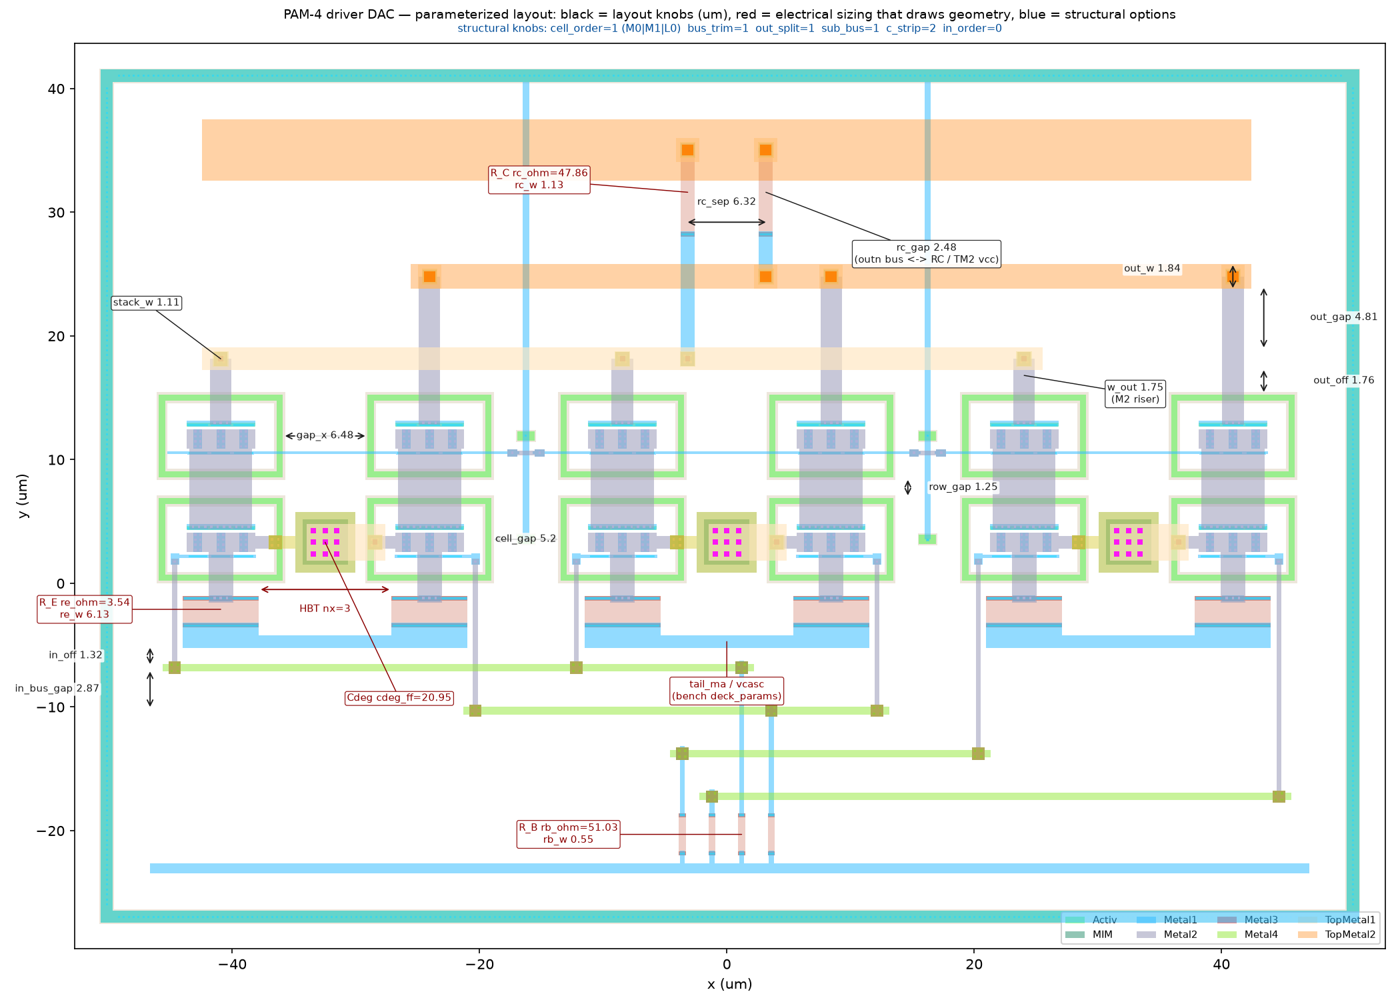
layout/codesign/pam4_layout_annotated.png
