MacAnalog/agentic-design-pam4-driver-ihp130/layout/codesign/rounds.png

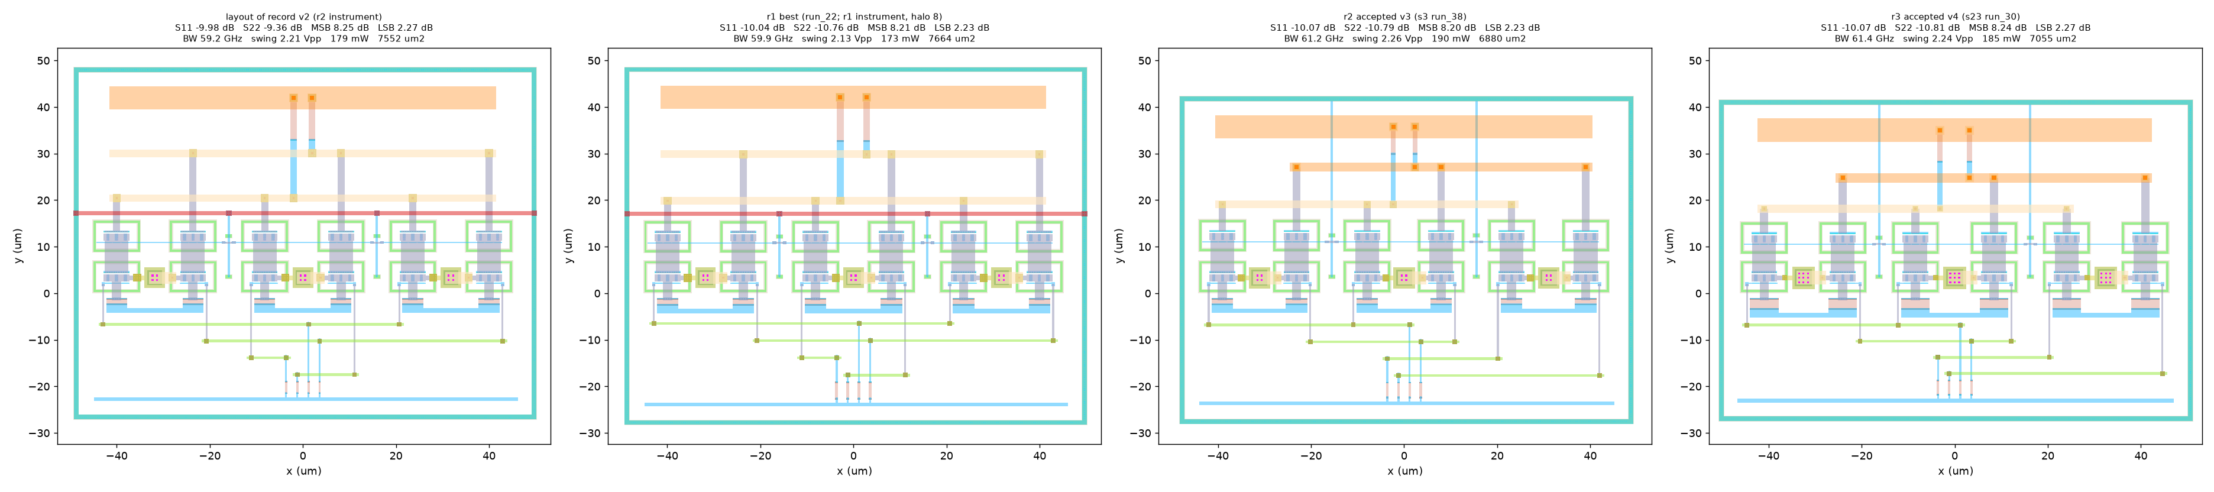
layout/codesign/rounds.png
