MacAnalog/agentic-design-pam4-driver-ihp130/layout/out/dut_lsb.png

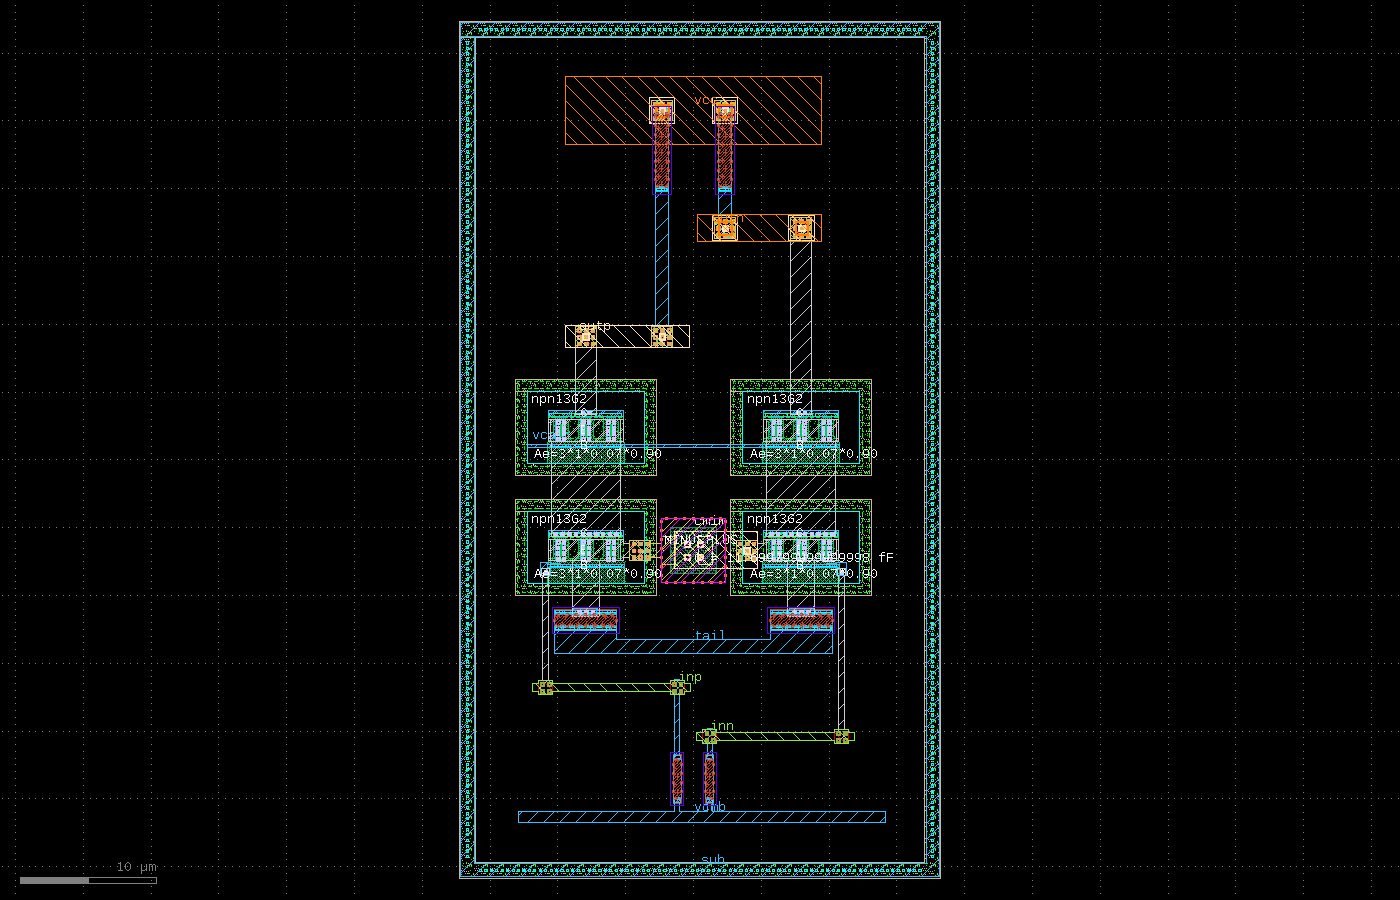
layout/out/dut_lsb.png
