MacAnalog/agentic-design-pam4-driver-ihp130/layout/out/dut_msb.png

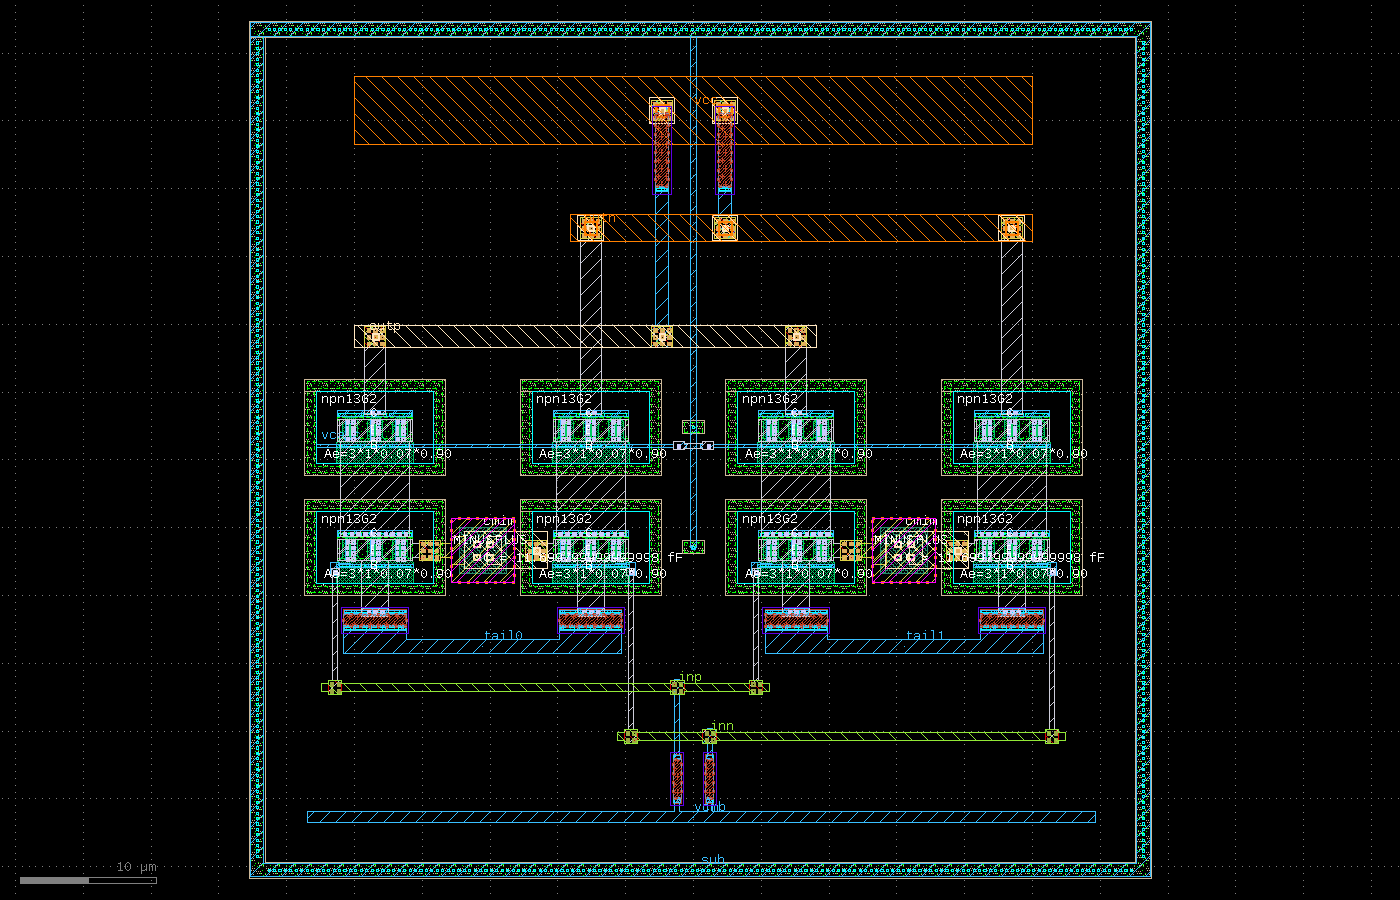
layout/out/dut_msb.png
