MacAnalog/agentic-design-pam4-driver-ihp130/notebooks/report_figs/eye_48gbd_pam4_v4.png

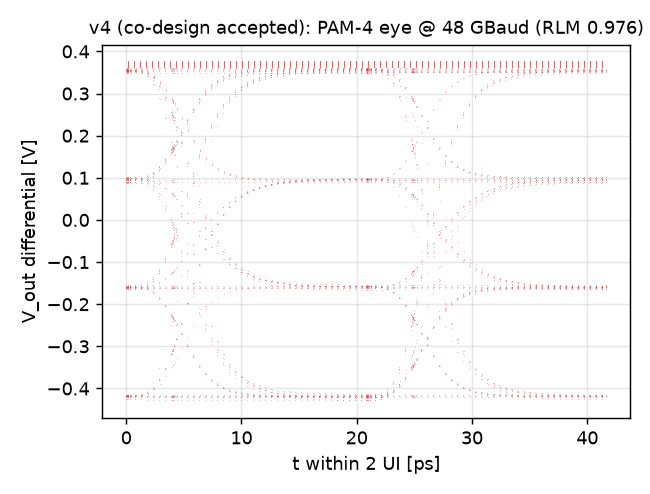
notebooks/report_figs/eye_48gbd_pam4_v4.png
