MacAnalog/agentic-design-pam4-driver-ihp130/report/layout/b/layout.png

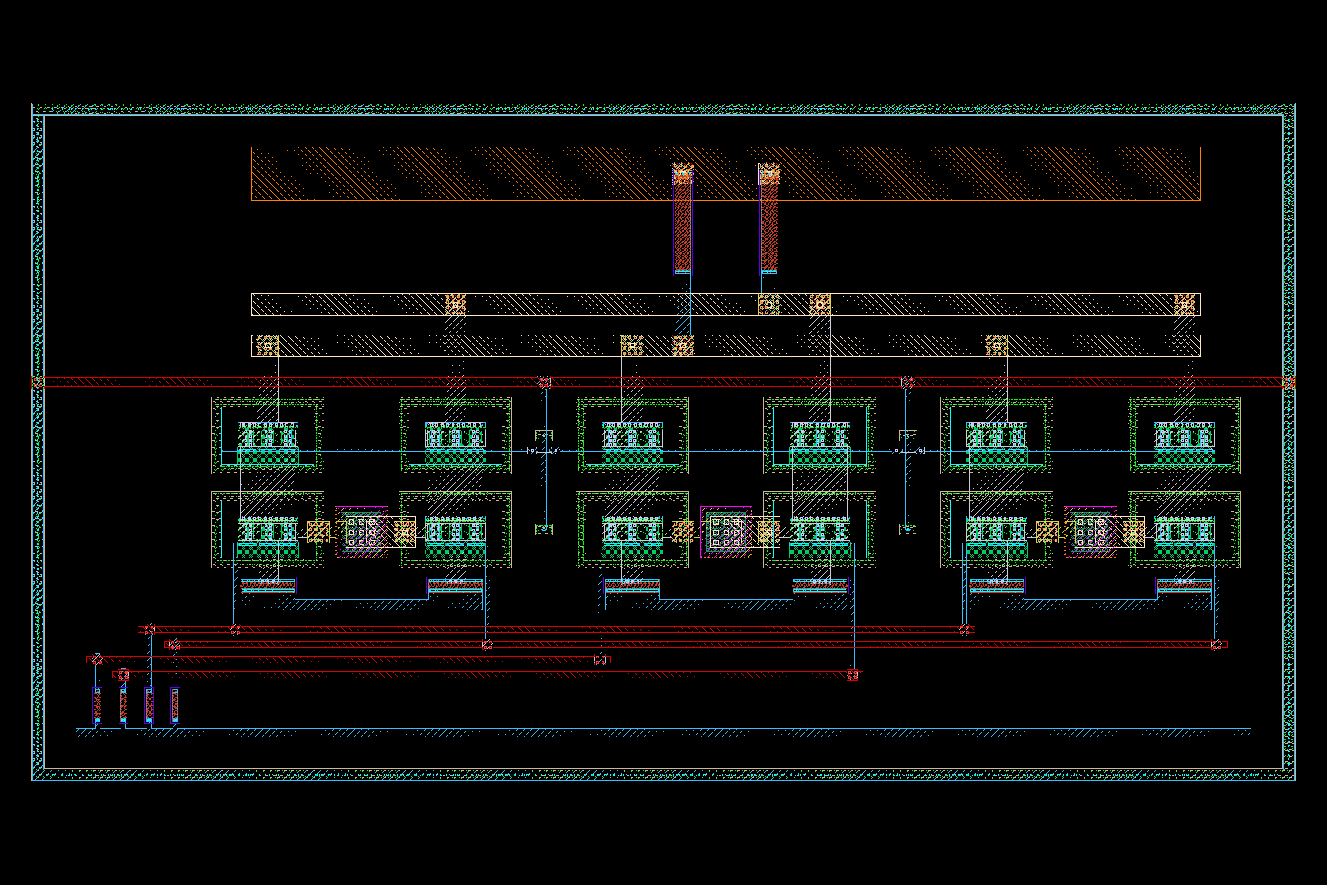
report/layout/b/layout.png
