MacAnalog/agentic-design-pam4-driver-ihp130/report/layout/c/layout.png

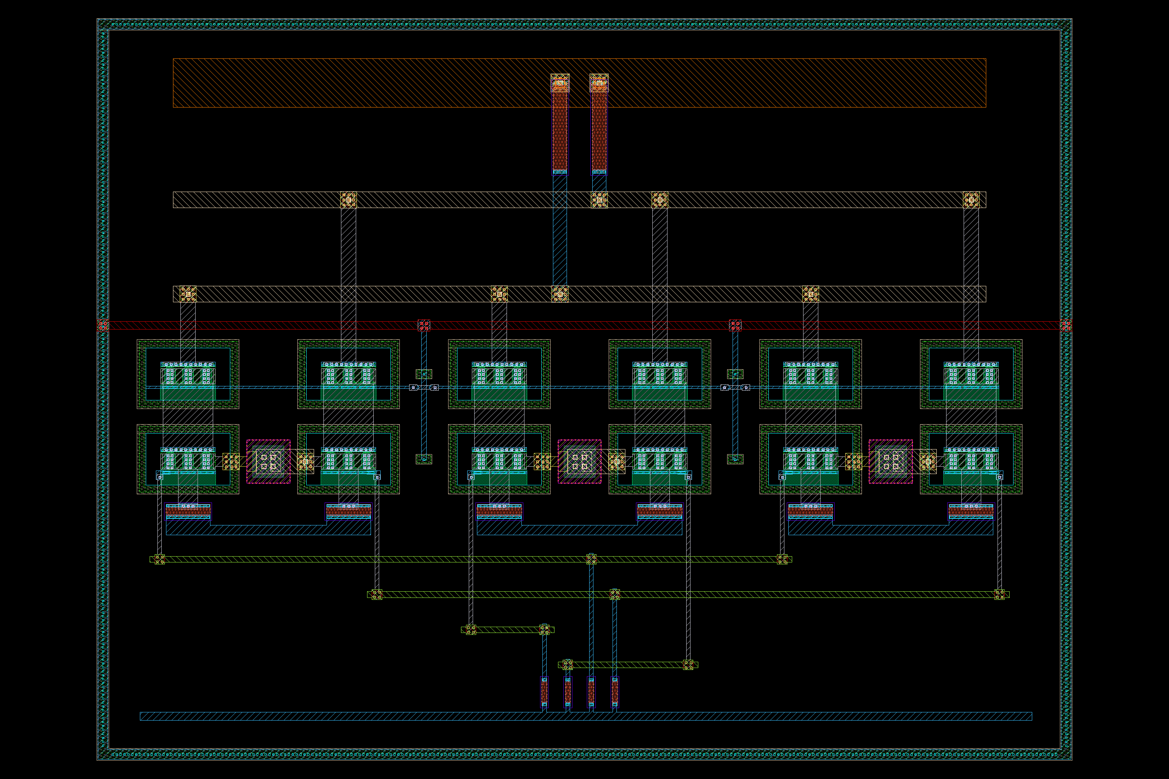
report/layout/c/layout.png
