MacAnalog/agentic-design-pam4-driver-ihp130/report/layout/d/layout.png

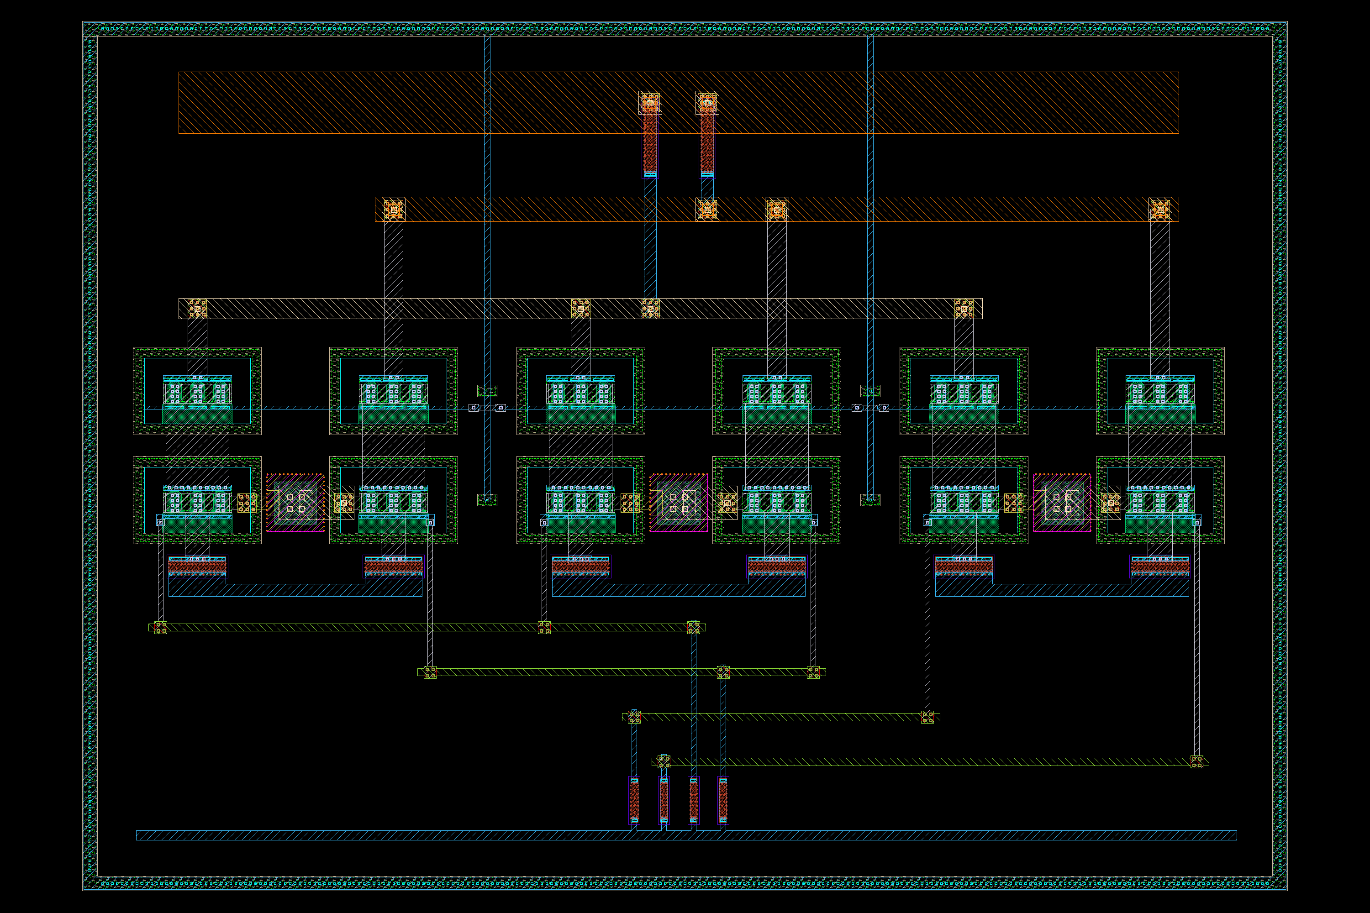
report/layout/d/layout.png
