MacAnalog/agentic-design-pam4-driver-ihp130/report/layout/e/layout.png

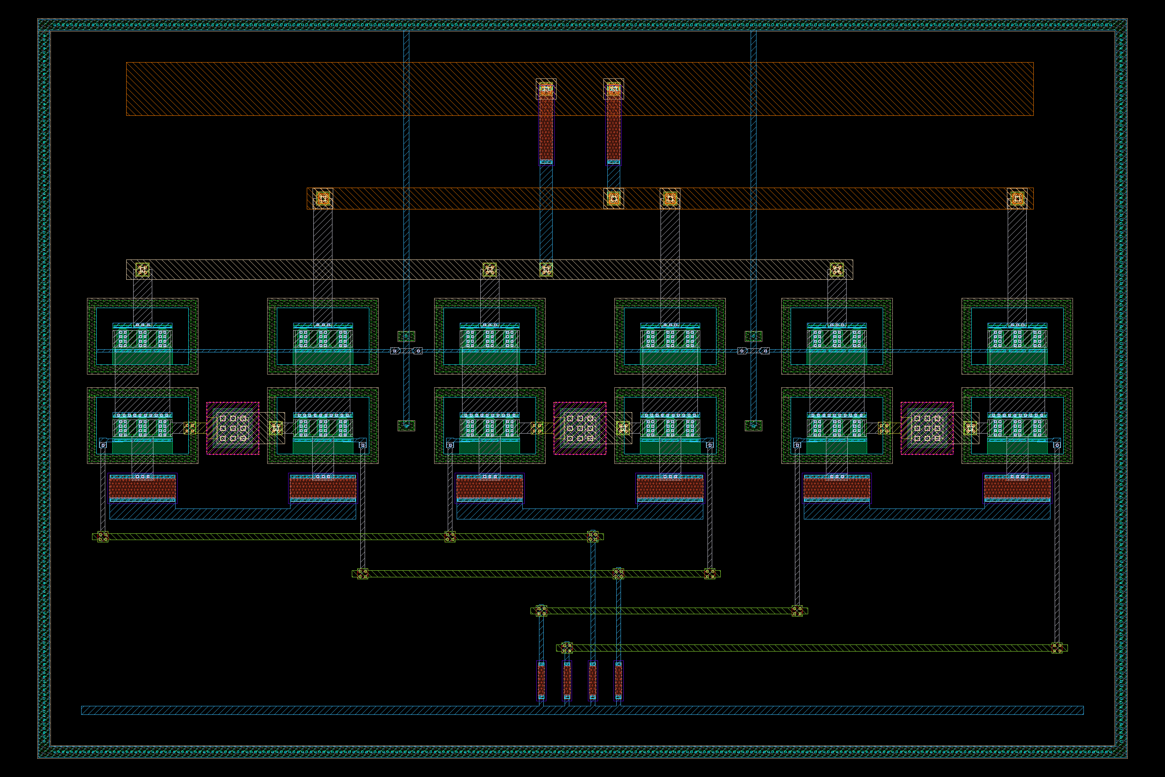
report/layout/e/layout.png
