MacAnalog/agentic-design-pam4-driver-ihp130/verification/decks/a/ac_lsb.csv

 1.00000000e+08  2.91547216e+00  1.00000000e+08 -4.49662449e+01
 1.02329299e+08  2.92262843e+00  1.02329299e+08 -4.49523706e+01
 1.04712855e+08  2.92952802e+00  1.04712855e+08 -4.49388886e+01
 1.07151931e+08  2.93617757e+00  1.07151931e+08 -4.49257828e+01
 1.09647820e+08  2.94258376e+00  1.09647820e+08 -4.49130369e+01
 1.12201845e+08  2.94875329e+00  1.12201845e+08 -4.49006348e+01
 1.14815362e+08  2.95469286e+00  1.14815362e+08 -4.48885602e+01
 1.17489755e+08  2.96040912e+00  1.17489755e+08 -4.48767966e+01
 1.20226443e+08  2.96590873e+00  1.20226443e+08 -4.48653278e+01
 1.23026877e+08  2.97119826e+00  1.23026877e+08 -4.48541373e+01
 1.25892541e+08  2.97628423e+00  1.25892541e+08 -4.48432088e+01
 1.28824955e+08  2.98117309e+00  1.28824955e+08 -4.48325260e+01
 1.31825674e+08  2.98587117e+00  1.31825674e+08 -4.48220725e+01
 1.34896288e+08  2.99038475e+00  1.34896288e+08 -4.48118320e+01
 1.38038426e+08  2.99471996e+00  1.38038426e+08 -4.48017883e+01
 1.41253754e+08  2.99888285e+00  1.41253754e+08 -4.47919251e+01
 1.44543977e+08  3.00287932e+00  1.44543977e+08 -4.47822261e+01
 1.47910839e+08  3.00671517e+00  1.47910839e+08 -4.47726752e+01
 1.51356125e+08  3.01039606e+00  1.51356125e+08 -4.47632562e+01
 1.54881662e+08  3.01392752e+00  1.54881662e+08 -4.47539528e+01
 1.58489319e+08  3.01731494e+00  1.58489319e+08 -4.47447489e+01
 1.62181010e+08  3.02056357e+00  1.62181010e+08 -4.47356282e+01
 1.65958691e+08  3.02367852e+00  1.65958691e+08 -4.47265745e+01
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
 9.33254301e+10  5.81418277e-02  9.33254301e+10 -9.03777771e+00
 9.54992586e+10 -6.17776623e-02  9.54992586e+10 -8.92003457e+00
 9.77237221e+10 -1.85623276e-01  9.77237221e+10 -8.80461841e+00
 1.00000000e+11 -3.13467588e-01  1.00000000e+11 -8.69155113e+00
