MacAnalog/agentic-design-pam4-driver-ihp130/verification/decks/a/ac_msb.csv

 1.00000000e+08  8.88789678e+00  1.00000000e+08 -3.89931445e+01
 1.02329299e+08  8.89497865e+00  1.02329299e+08 -3.89793788e+01
 1.04712855e+08  8.90180636e+00  1.04712855e+08 -3.89660022e+01
 1.07151931e+08  8.90838650e+00  1.07151931e+08 -3.89529987e+01
 1.09647820e+08  8.91472569e+00  1.09647820e+08 -3.89403521e+01
 1.12201845e+08  8.92083057e+00  1.12201845e+08 -3.89280462e+01
 1.14815362e+08  8.92670777e+00  1.14815362e+08 -3.89160647e+01
 1.17489755e+08  8.93236390e+00  1.17489755e+08 -3.89043913e+01
 1.20226443e+08  8.93780555e+00  1.20226443e+08 -3.88930097e+01
 1.23026877e+08  8.94303923e+00  1.23026877e+08 -3.88819037e+01
 1.25892541e+08  8.94807140e+00  1.25892541e+08 -3.88710568e+01
 1.28824955e+08  8.95290845e+00  1.28824955e+08 -3.88604528e+01
 1.31825674e+08  8.95755666e+00  1.31825674e+08 -3.88500754e+01
 1.34896288e+08  8.96202222e+00  1.34896288e+08 -3.88399085e+01
 1.38038426e+08  8.96631124e+00  1.38038426e+08 -3.88299357e+01
 1.41253754e+08  8.97042968e+00  1.41253754e+08 -3.88201409e+01
 1.44543977e+08  8.97438341e+00  1.44543977e+08 -3.88105080e+01
 1.47910839e+08  8.97817815e+00  1.47910839e+08 -3.88010207e+01
 1.51356125e+08  8.98181951e+00  1.51356125e+08 -3.87916630e+01
 1.54881662e+08  8.98531297e+00  1.54881662e+08 -3.87824188e+01
 1.58489319e+08  8.98866386e+00  1.58489319e+08 -3.87732718e+01
 1.62181010e+08  8.99187738e+00  1.62181010e+08 -3.87642059e+01
 1.65958691e+08  8.99495859e+00  1.65958691e+08 -3.87552051e+01
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
 9.33254301e+10  4.09508538e+00  9.33254301e+10 -4.97257208e+00
 9.54992586e+10  3.93260261e+00  9.54992586e+10 -4.89794571e+00
 9.77237221e+10  3.76629624e+00  9.77237221e+10 -4.82559079e+00
 1.00000000e+11  3.59613702e+00  1.00000000e+11 -4.75548452e+00
