MacAnalog/agentic-design-pam4-driver-ihp130/verification/decks/a/balance.csv

 1.00000000e+08  2.86729686e+00  1.00000000e+08  2.86729686e+00  1.00000000e+08 -1.76785149e+02  1.00000000e+08  3.21485093e+00  1.00000000e+08 -2.95565614e+02  1.00000000e+08  2.86729686e+00
 1.02329299e+08  2.87437874e+00  1.02329299e+08  2.87437874e+00  1.02329299e+08 -1.76848435e+02  1.02329299e+08  3.15156536e+00  1.02329299e+08 -2.93506212e+02  1.02329299e+08  2.87437874e+00
 1.04712855e+08  2.88120645e+00  1.04712855e+08  2.88120645e+00  1.04712855e+08 -1.76911333e+02  1.04712855e+08  3.08866673e+00  1.04712855e+08 -2.93952777e+02  1.04712855e+08  2.88120645e+00
 1.07151931e+08  2.88778659e+00  1.07151931e+08  2.88778659e+00  1.07151931e+08 -1.76973810e+02  1.07151931e+08  3.02619046e+00  1.07151931e+08 -2.94476024e+02  1.07151931e+08  2.88778659e+00
 1.09647820e+08  2.89412578e+00  1.09647820e+08  2.89412578e+00  1.09647820e+08 -1.77035831e+02  1.09647820e+08  2.96416917e+00  1.09647820e+08 -2.89539514e+02  1.09647820e+08  2.89412578e+00
 1.12201845e+08  2.90023065e+00  1.12201845e+08  2.90023065e+00  1.12201845e+08 -1.77097367e+02  1.12201845e+08  2.90263276e+00  1.12201845e+08 -2.92239018e+02  1.12201845e+08  2.90023065e+00
 1.14815362e+08  2.90610785e+00  1.14815362e+08  2.90610785e+00  1.14815362e+08 -1.77158391e+02  1.14815362e+08  2.84160851e+00  1.14815362e+08 -2.98245985e+02  1.14815362e+08  2.90610785e+00
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
 9.77237221e+10 -2.25430367e+00  9.77237221e+10 -2.25430367e+00  9.77237221e+10  7.88174329e+01  9.77237221e+10 -1.01182567e+02  9.77237221e+10 -2.96642760e+02  9.77237221e+10 -2.25430367e+00
 1.00000000e+11 -2.42446290e+00  1.00000000e+11 -2.42446290e+00  1.00000000e+11  7.71300197e+01  1.00000000e+11 -1.02869980e+02  1.00000000e+11 -2.94727387e+02  1.00000000e+11 -2.42446290e+00
