MacAnalog/agentic-design-pam4-driver-ihp130/verification/decks/a/bias.csv

 2.33333000e-13  8.08252892e-05  2.33333000e-13 -2.86729686e-06
 4.66666000e-13  1.69498420e-04  4.66666000e-13 -5.10676642e-06
 9.33332000e-13  3.60578016e-04  9.33332000e-13 -8.48703875e-06
 1.86666400e-12  7.91313435e-04  1.86666400e-12 -1.13614852e-05
 3.73332800e-12  1.70914756e-03  3.73332800e-12 -1.26013152e-05
 7.46665600e-12  3.57259859e-03  7.46665600e-12 -1.28583531e-05
 1.49333120e-11  7.29948357e-03  1.49333120e-11 -1.33737941e-05
 2.33333000e-11  1.14963575e-02  2.33333000e-11 -1.36233999e-05
 2.48266312e-11  1.22425531e-02  2.48266312e-11 -1.36609975e-05
 2.78132936e-11  1.37351910e-02  2.78132936e-11 -1.37164651e-05
 3.37866184e-11  1.67209943e-02  3.37866184e-11 -1.37851929e-05
 4.57332680e-11  2.26935508e-02  4.57332680e-11 -1.38466593e-05
 6.90665680e-11  3.43603071e-02  6.90665680e-11 -1.38381509e-05
 9.23998680e-11  4.60276152e-02  9.23998680e-11 -1.37855075e-05
 1.15733168e-10  5.76812148e-02  1.15733168e-10 -1.48295357e-05
 1.39066468e-10  6.93640669e-02  1.39066468e-10 -1.35333694e-05
 1.62399768e-10  8.10310204e-02  1.62399768e-10 -1.35090863e-05
 1.85733068e-10  9.25679436e-02  1.85733068e-10 -2.38872291e-05
 2.09066368e-10  9.71544241e-02  2.09066368e-10 -5.90300791e-04
 2.32399668e-10  1.03753097e-01  2.32399668e-10 -9.95738961e-04
 2.55732968e-10  1.14376824e-01  2.55732968e-10 -1.07917276e-03
 2.79066268e-10  1.23407784e-01  2.79066268e-10 -1.29002803e-03
 3.02399568e-10  1.33139338e-01  3.02399568e-10 -1.44483571e-03
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
 1.35883253e-08  3.40308084e+00  1.35883253e-08 -4.77535327e-02
 1.36116586e-08  3.40308159e+00  1.36116586e-08 -4.77534726e-02
 1.36349919e-08  3.40308232e+00  1.36349919e-08 -4.77534146e-02
 1.36583252e-08  3.40308306e+00  1.36583252e-08 -4.77533551e-02
 1.36816585e-08  3.40308378e+00  1.36816585e-08 -4.77532975e-02
 1.37049918e-08  3.40308452e+00  1.37049918e-08 -4.77532386e-02
 1.37283251e-08  3.40308523e+00  1.37283251e-08 -4.77531816e-02
 1.37516584e-08  3.40308596e+00  1.37516584e-08 -4.77531231e-02
 1.37749917e-08  3.40308667e+00  1.37749917e-08 -4.77530667e-02
 1.37983250e-08  3.40308739e+00  1.37983250e-08 -4.77530088e-02
 1.38216583e-08  3.40308809e+00  1.38216583e-08 -4.77529529e-02
 1.38449916e-08  3.40308881e+00  1.38449916e-08 -4.77528954e-02
 1.38683249e-08  3.40308950e+00  1.38683249e-08 -4.77528401e-02
 1.38916582e-08  3.40309021e+00  1.38916582e-08 -4.77527832e-02
 1.39149915e-08  3.40309090e+00  1.39149915e-08 -4.77527283e-02
 1.39383248e-08  3.40309160e+00  1.39383248e-08 -4.77526719e-02
 1.39616581e-08  3.40309228e+00  1.39616581e-08 -4.77526175e-02
 1.39849914e-08  3.40309298e+00  1.39849914e-08 -4.77525616e-02
 1.40000000e-08  3.40309341e+00  1.40000000e-08 -4.77525268e-02
