MacAnalog/agentic-design-pam4-driver-ihp130/verification/decks/a/dc.csv

-9.00000000e-01  1.18436938e+00 -9.00000000e-01 -4.73774939e-02
-8.85000000e-01  1.18434188e+00 -8.85000000e-01 -4.73772609e-02
-8.70000000e-01  1.18430773e+00 -8.70000000e-01 -4.73770381e-02
-8.55000000e-01  1.18426481e+00 -8.55000000e-01 -4.73768287e-02
-8.40000000e-01  1.18421033e+00 -8.40000000e-01 -4.73766370e-02
-8.25000000e-01  1.18414062e+00 -8.25000000e-01 -4.73764687e-02
-8.10000000e-01  1.18405085e+00 -8.10000000e-01 -4.73763312e-02
-7.95000000e-01  1.18393465e+00 -7.95000000e-01 -4.73762338e-02
-7.80000000e-01  1.18378369e+00 -7.80000000e-01 -4.73761899e-02
-7.65000000e-01  1.18358702e+00 -7.65000000e-01 -4.73762159e-02
-7.50000000e-01  1.18333029e+00 -7.50000000e-01 -4.73763335e-02
-7.35000000e-01  1.18299479e+00 -7.35000000e-01 -4.73765714e-02
-7.20000000e-01  1.18255611e+00 -7.20000000e-01 -4.73769663e-02
-7.05000000e-01  1.18198263e+00 -7.05000000e-01 -4.73775657e-02
-6.90000000e-01  1.18123356e+00 -6.90000000e-01 -4.73784306e-02
-6.75000000e-01  1.18025666e+00 -6.75000000e-01 -4.73796386e-02
-6.60000000e-01  1.17898568e+00 -6.60000000e-01 -4.73812864e-02
-6.45000000e-01  1.17733755e+00 -6.45000000e-01 -4.73834940e-02
-6.30000000e-01  1.17520983e+00 -6.30000000e-01 -4.73864058e-02
-6.15000000e-01  1.17247867e+00 -6.15000000e-01 -4.73901915e-02
-6.00000000e-01  1.16899808e+00 -6.00000000e-01 -4.73950432e-02
-5.85000000e-01  1.16460149e+00 -5.85000000e-01 -4.74011673e-02
-5.70000000e-01  1.15910616e+00 -5.70000000e-01 -4.74087727e-02
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
 8.55000000e-01 -1.18426481e+00  8.55000000e-01 -4.73768287e-02
 8.70000000e-01 -1.18430773e+00  8.70000000e-01 -4.73770381e-02
 8.85000000e-01 -1.18434188e+00  8.85000000e-01 -4.73772609e-02
 9.00000000e-01 -1.18436938e+00  9.00000000e-01 -4.73774939e-02
