MacAnalog/agentic-design-pam4-driver-ihp130/verification/decks/a/eye.csv

 5.20833000e-15  1.11722730e-04
 1.04166600e-14  2.67456741e-04
 2.08333200e-14  6.02252091e-04
 4.16666400e-14  1.17009794e-03
 8.33332800e-14  1.63430749e-03
 1.66666560e-13  1.51234304e-03
 3.31656420e-13  9.20626140e-04
 5.20833000e-13  5.01889132e-04
 5.42610349e-13  4.58562674e-04
 5.86165048e-13  3.78945779e-04
 6.73274446e-13  2.43374342e-04
 8.47493241e-13  3.12166922e-05
 1.19593083e-12 -2.13053886e-04
 1.71676383e-12 -3.07747917e-04
 2.23759683e-12 -2.57911136e-04
 2.75842983e-12 -1.81081114e-04
 3.27926283e-12 -1.17276439e-04
 3.80009583e-12 -7.26647140e-05
 4.32092883e-12 -4.36332084e-05
 4.84176183e-12 -2.58079793e-05
 5.36259483e-12 -1.49064814e-05
 5.88342783e-12 -8.62558794e-06
 6.40426083e-12 -4.80975753e-06
 6.92509383e-12 -2.76171484e-06
 7.44592683e-12 -1.44653176e-06
 7.96675983e-12 -8.39504609e-07
 8.48759283e-12 -3.65687106e-07
 9.00842583e-12 -2.26573865e-07
 9.52925883e-12 -3.06291033e-08
 1.00500918e-11 -3.63044742e-08
 1.05709248e-11  6.66975507e-08
 1.10917578e-11  2.01301798e-08
 1.16125908e-11  8.98753954e-08
 1.21334238e-11  3.48251388e-08
 1.26542568e-11  9.06183400e-08
 1.31750898e-11  3.67160177e-08
 1.36959228e-11  8.50312317e-08
 1.42167558e-11  3.47994010e-08
 1.47375888e-11  7.80430581e-08
 1.52584218e-11  3.18524472e-08
 1.57792548e-11  7.11140585e-08
 1.63000878e-11  2.87288813e-08
 1.68209208e-11  6.46398799e-08
 1.73417538e-11  2.56904535e-08
 1.78625868e-11  5.86952146e-08
 1.83834198e-11  2.28163837e-08
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
 1.92775720e-09  1.93867138e-04
 1.92827803e-09  1.95251587e-04
 1.92879886e-09  1.96645503e-04
 1.92931970e-09  1.98048944e-04
 1.92984053e-09  1.99461969e-04
 1.93036136e-09  2.00884640e-04
 1.93088220e-09  2.02317015e-04
 1.93140303e-09  2.03759155e-04
 1.93192386e-09  2.05211121e-04
 1.93244469e-09  2.06672973e-04
 1.93296553e-09  2.08144772e-04
 1.93348636e-09  2.09626580e-04
 1.93400719e-09  2.11118458e-04
 1.93452803e-09  2.12620469e-04
 1.93504886e-09  2.14132675e-04
 1.93556969e-09  2.15655138e-04
 1.93609053e-09  2.17187922e-04
 1.93661136e-09  2.18731089e-04
 1.93713219e-09  2.20284703e-04
 1.93765302e-09  2.21848828e-04
 1.93817386e-09  2.23423529e-04
 1.93869469e-09  2.25008868e-04
 1.93921552e-09  2.26604912e-04
 1.93973636e-09  2.28211724e-04
 1.94025719e-09  2.29829371e-04
 1.94077802e-09  2.31457918e-04
 1.94129886e-09  2.33097430e-04
 1.94181969e-09  2.34747975e-04
 1.94234052e-09  2.36409617e-04
 1.94286135e-09  2.38082425e-04
 1.94338219e-09  2.39766465e-04
 1.94390302e-09  2.41461805e-04
 1.94442385e-09  2.43168512e-04
 1.94494469e-09  2.44886654e-04
 1.94546552e-09  2.46616299e-04
 1.94598635e-09  2.48357517e-04
 1.94650719e-09  2.50110375e-04
 1.94702802e-09  2.51874943e-04
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
