MacAnalog/agentic-design-pam4-driver-ihp130/layout/codesign/results/r3/best.png

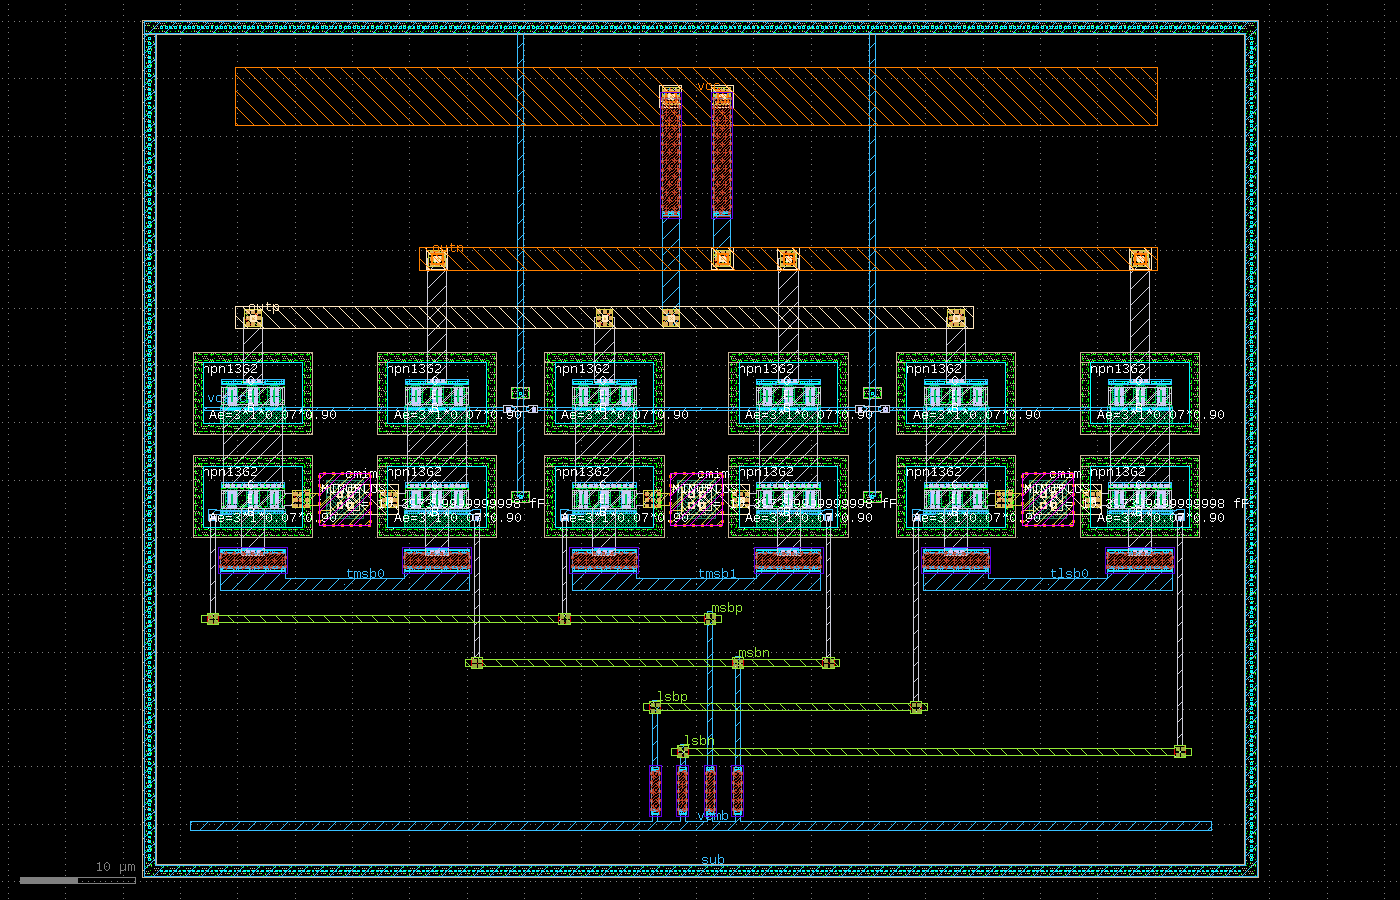
layout/codesign/results/r3/best.png
