MacAnalog/agentic-design-pam4-driver-ihp130/report/figs/fig_dc.pdf

1.0

## DC transfer (swing spec ≥ 2.1 Vpp = ±1.05 V)

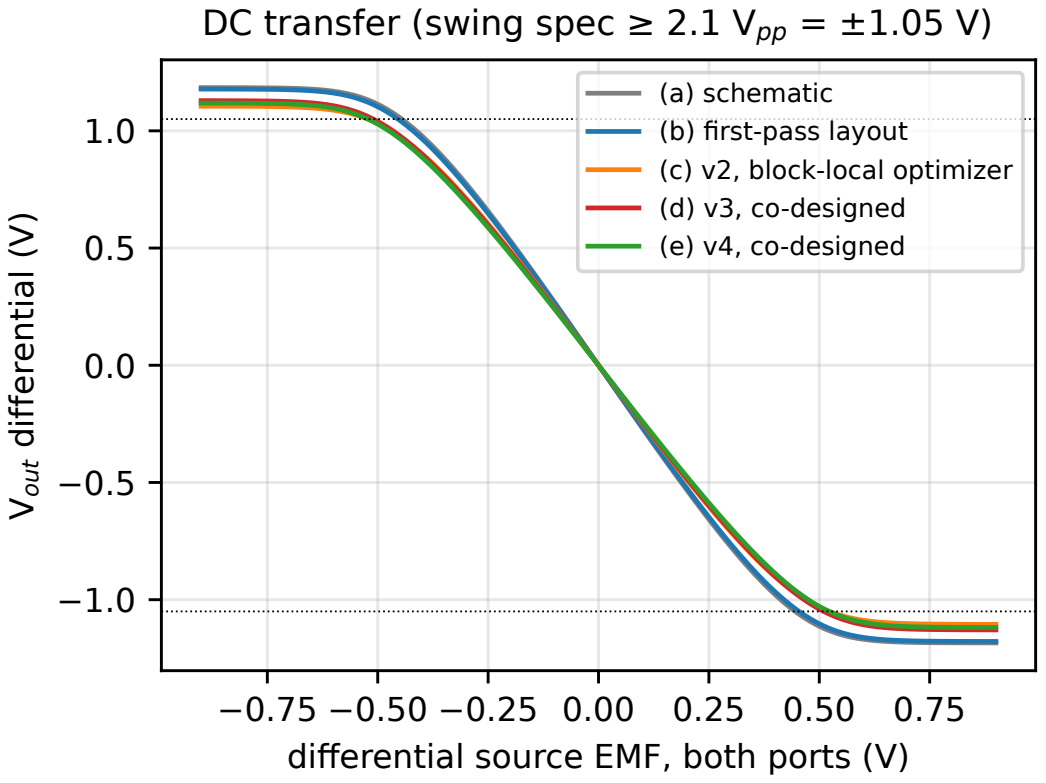
[picture p29: page 1]
Vout differential (V)

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

differential source EMF, both ports (V)
