MacAnalog/agentic-design-pam4-driver-ihp130/report/figs/fig_sparams.pdf

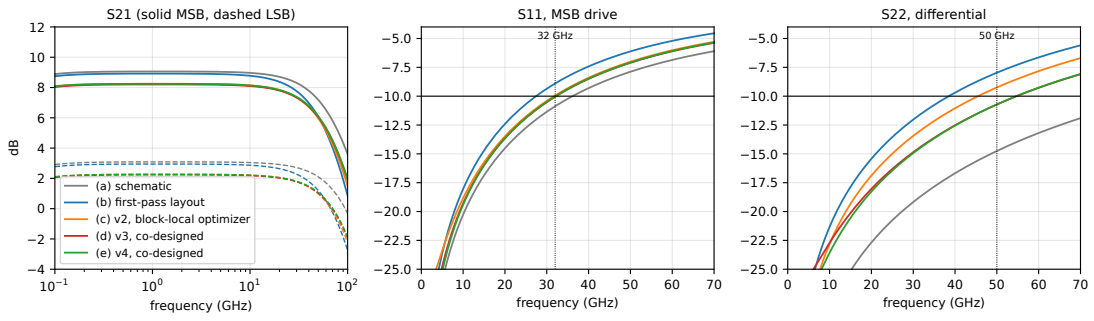
[picture p30: page 1]
frequency (GHz); 32 GHz; S11, MSB drive; 50 GHz; fferential

S21 (solid MSB, dashed LSB)

(a) schematic (b) first-pass layout

(c) v2, block-local optimizer (d) v3, co-designed

(e) v4, co-designed
