MacAnalog/agentic-design-pam4-driver-ihp130/report/schematic/pam4_architecture_vector.pdf

## vcc

## outp

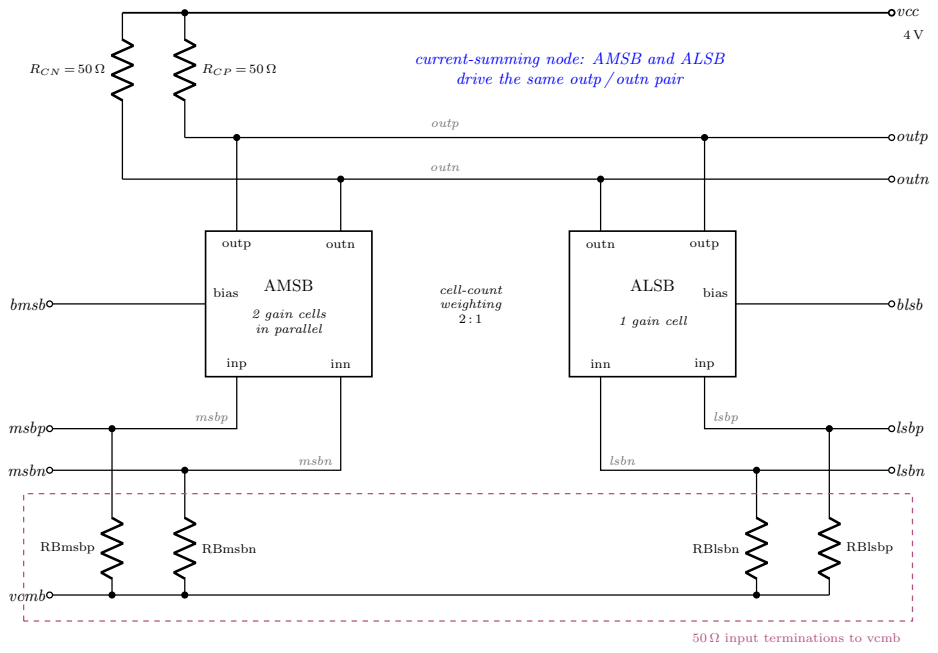
[picture p31: page 1]
RCN = 50 Ω; RCP = 50 Ω; outn; outp; AMSB; 2 gain cells in parallel; inp; inn; bias; ALSB; 1 gain cell; bias cell-count weighting 2 : 1; bmsb; blsb; msbp; msbn; lsbp; lsbn; vcmb; RBmsbp; RBmsbn; RBlsbn; RBlsbp

current-summing node: AMSB and ALSB
drive the same outp / outn pair

50 Ω input terminations to vcmb
