MacAnalog/agentic-design-pam4-driver-ihp130/layout/codesign/pam4_layout_annotated.pdf

30

40

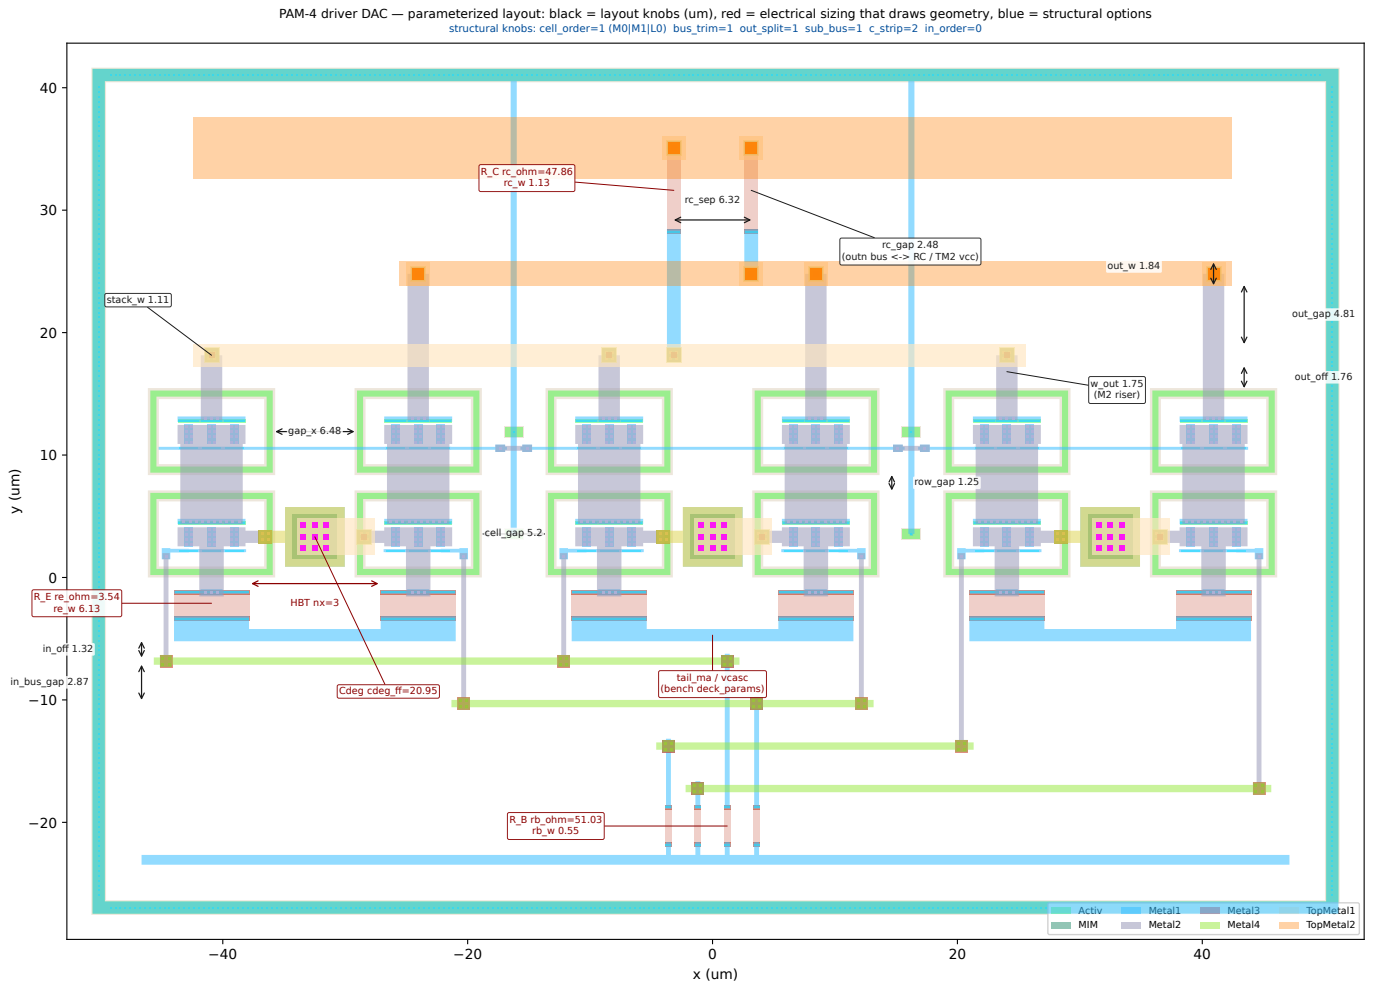
[picture p32: page 1]
structural knobs: cell_order=1 (M0|M1|L0) bus_trim=1 out_split=1 sub_bus=1 c_strip=2 in_order=0; Activ MIM; Metal1 Metal2; Metal3 Metal4; TopMetal1 TopMetal2; HBT nx=3; gap_x 6.48; cell_gap 5.2; row_gap 1.25; out_gap 4.81; out_w 1.84; out_off 1.76; rc_sep 6.32; rc_gap 2.48; R_C rc_ohm=47.86 rc_w 1.13; w_out 1.75 (M2 riser); stack_w 1.11; Cdeg cdeg_ff=20.95; R_E re_ohm=3.54 re_w 6.13; in_off 1.32; in_bus_gap 2.87; R_B rb_ohm=51.03 rb_w 0.55; tail_ma / vcasc (bench deck_params)

PAM-4 driver DAC — parameterized layout: black = layout knobs (um), red = electrical sizing that draws geometry, blue = structural options

(outn bus <-> RC / TM2 vcc)
