MacAnalog/agentic-design-pam4-driver-ihp130/report/schematic/pam4_msb_vector.pdf

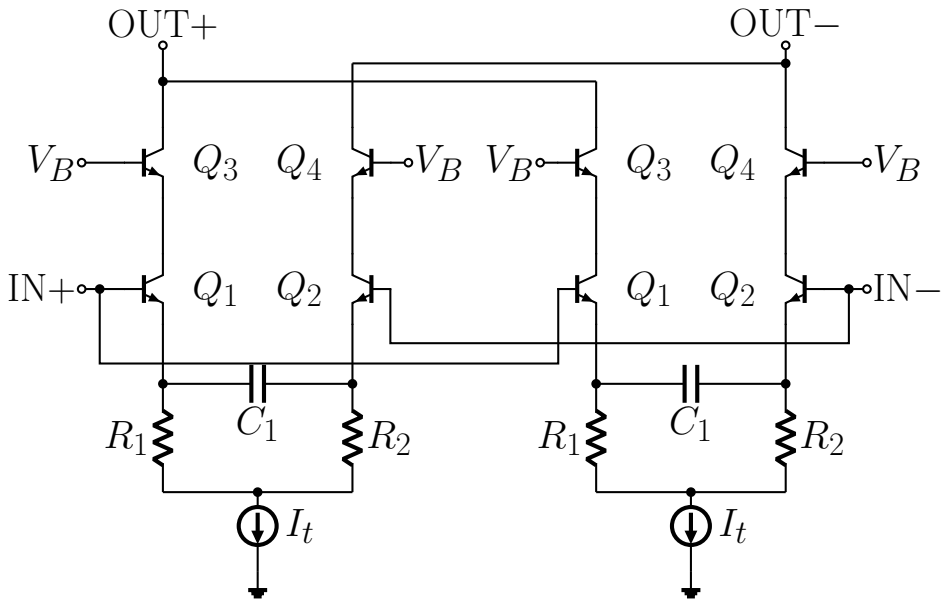
[picture p33: page 1]
OUT+; OUT−
