MacAnalog/agentic-design-pam4-driver-ihp130/(commit log)

2026-08-09 porting the desing and workflow files
    [dut_lsb.sch, dut_msb.sch, dut_pam4.sch, dut_pam4_flat.sch]
2026-08-18 Layout/schematic co-design through the SpiceXplorer platform (Alg. 1): v3 point — S11 −10.05 / S22 −10.72 dB at the band edges, 6880 µm², all 8 specs (#1)
    * codesign: wire the pam4 DUT into spicexplorer-optimize (layout-flow measure hook) + parity
    - gen_layout: device_records() (netlists without drawing), generator
    contract build()/write_lvs_reference()/write_pex_schematic()/write_sim_netlist()
    - pex_sim: convert_pex_netlist(cap=) / cap_reinsert_args(params)
    - layout/codesign/: flow.yaml (layout-flow/1), project_setup.yaml (theta_E +
    theta_L knobs, 8 signoff specs + S11/S22 margin reward), measure_post.py,
    run_round.sh, harvest.py; tests/test_gen_records.py
    - parity: trial 0 a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
    [balance_a.csv, balance_b.csv, balance_c.csv, balance_d.csv, dc_a.csv, dc_b.csv, dc_c.csv, dc_d.csv]
2026-08-19 verification/: re-run every final number by hand (static decks + checker); S-parameters via ngspice sp analysis everywhere (#2)
    * verification/: static ngspice decks + extractor + checker for every final number (make verify-report)
    What was done
    - verification/dump_decks.py: per tier (a schematic, b first-pass, c v2, d v3) the 7 decks (ac_lsb, ac_msb, s22, balance, dc, bias, eye) written by driver_lib's own builders, relative include of report/layout/<tier>/dut_pam4_post.spice, .spiceinit, meta.json
    - verification/extract.py: CSV -> every number with its definition (formulas == measure_post / build_report), numpy only
    - verification/verify.py: runs ngspice on each deck, extracts, compares w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
2026-08-19 co-design round 3: p/n balance objective; v4 accepted as the layout of record (#3)
    * co-design round 3: p/n balance as an objective; v4 accepted as the layout of record
    - gen_layout: FINAL_LAYOUT/FINAL_BIASES = v4 (r3 island s23 run_30); v3 kept as V3_LAYOUT/V3_BIASES
    - generator G: out_split 2/3 (symmetric/mirrored output-bus metal), in_order (p/n-swapped
    input rows) and rc_gap (outn bus <-> RC body and the TM2 vcc rail) as knobs
    - measure_post: p/n balance of the LSB path measured too (unscored *_lsb scalars)
    - project_setup: balance + power rewarded in J; 14 island copies in rounds/
    - harvest --accept records the accepted trial next to argmax-J; figures.py prefers it
    - remeasure.py + f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
    [ac_lsb.csv, ac_msb.csv, balance.csv, balance_e.csv, bias.csv, dc.csv, dc_e.csv, eye.csv]
2026-09-26 doc: optimize_layout.py names the platform's live layout optimizer, not the retired prototype
    The docstring pointed at the platform's
    examples/layout/ihp-sg13g2/5t_ota_gf/optimize_layout.py, which the platform
    retired on 2026-09-26 (MacAnalog/spicexplorer-platform#304). It now says
    this script was written on that pattern, names the live path (the
    5t_ota_gf/opt/ project with `sim_engine: layout`, DRC/LVS/PEX through
    spicexplorer-signoff), and states that this script imports nothing from
    the platform: DRC/LVS come from this repo's own pdk_runner/ copy through
    signoff.py, PEX from pex_sim.py. Docstring text only.
    D-DES-1
2026-09-26 doc: optimize_layout.py names the platform's live layout optimizer, not the retired prototype (#12)
    ## What was done
    - `layout/optimize_layout.py` docstring: it pointed at the platform's `examples/layout/ihp-sg13g2/5t_ota_gf/optimize_layout.py`, which the platform retired on 2026-09-26 (MacAnalog/spicexplorer-platform#304). It now names the live path, the `5t_ota_gf/opt/` project (`sim_engine: layout`, DRC/LVS/PEX through `spicexplorer-signoff`), and says this script imports nothing from the platform (DRC/LVS from the repo's own `pdk_runner/` copy via `signoff.py`, PEX and the post-layout bench from `pex_sim.py`). Text only.
    ## Assumptions
    - `layout/README.md:6` cites the `5t_ota_gf/` direc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
